pbaron2/station-sol-supsat/antenne/synthese-projet.docx

substrat FR4 : er=4.3, h=1.586 mm

cuivre : 18µm d'épaisseur

coupleur 3dB/90°

w=3L=95.5, w=3L=98, w=3

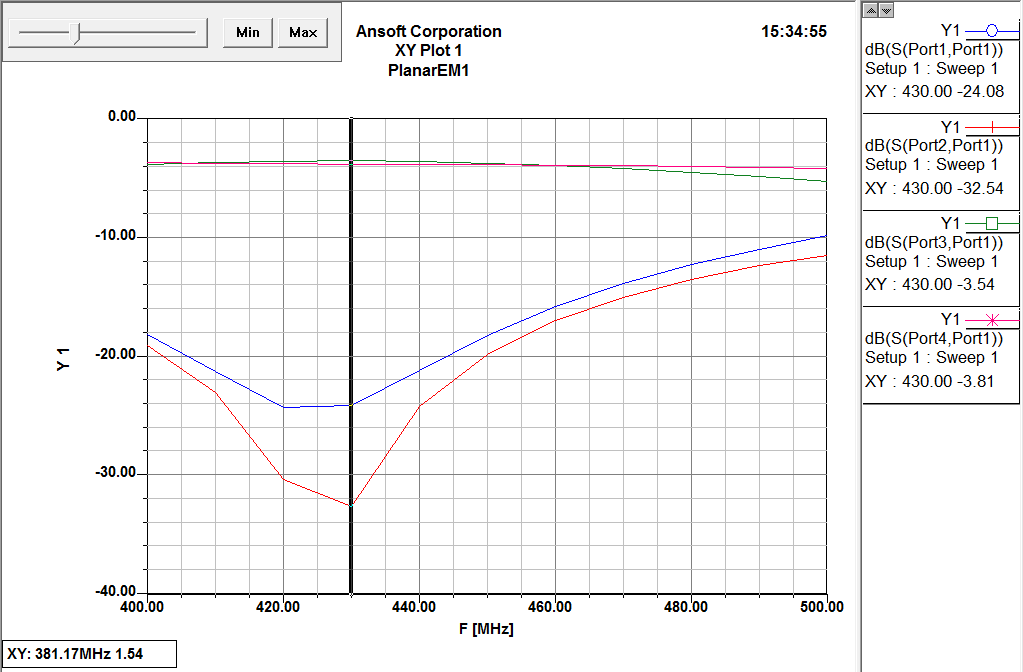
[picture p1: figure]
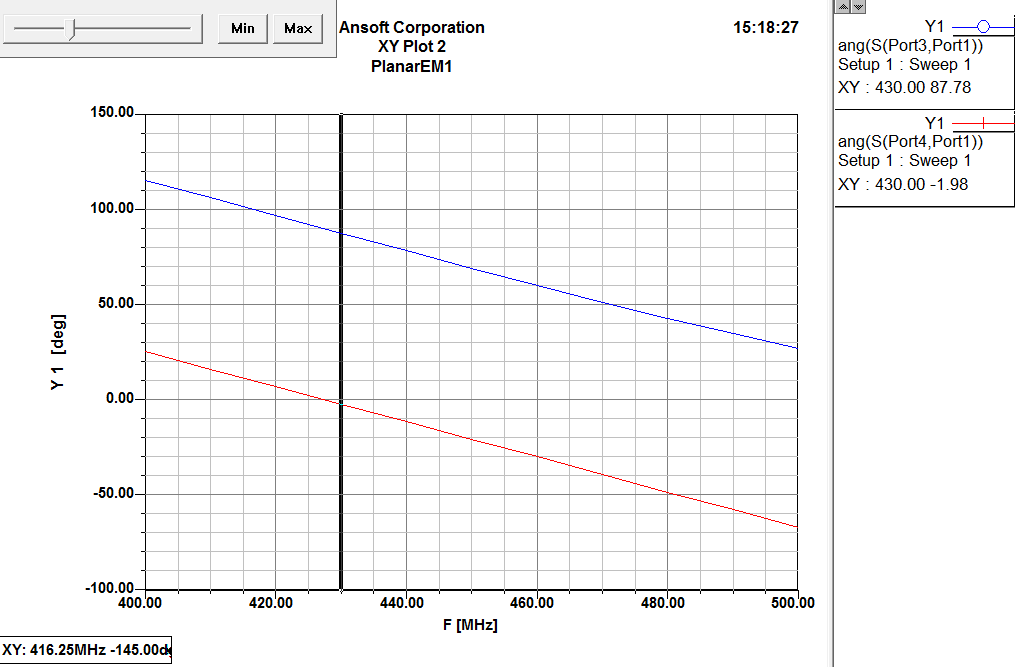
[picture p2: figure]

coupleur 3dB/180°

L=96, w=1.6L=96, w=1.6L=33.2L=29.6L=10L=15L=29.6L=33L=33

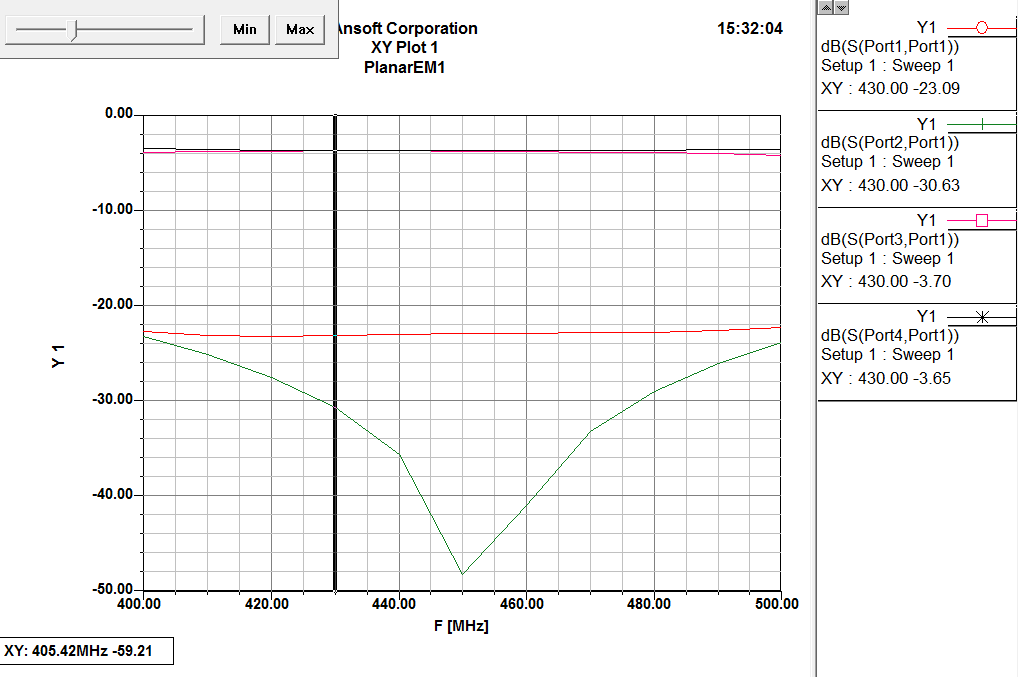
[picture p3: figure]
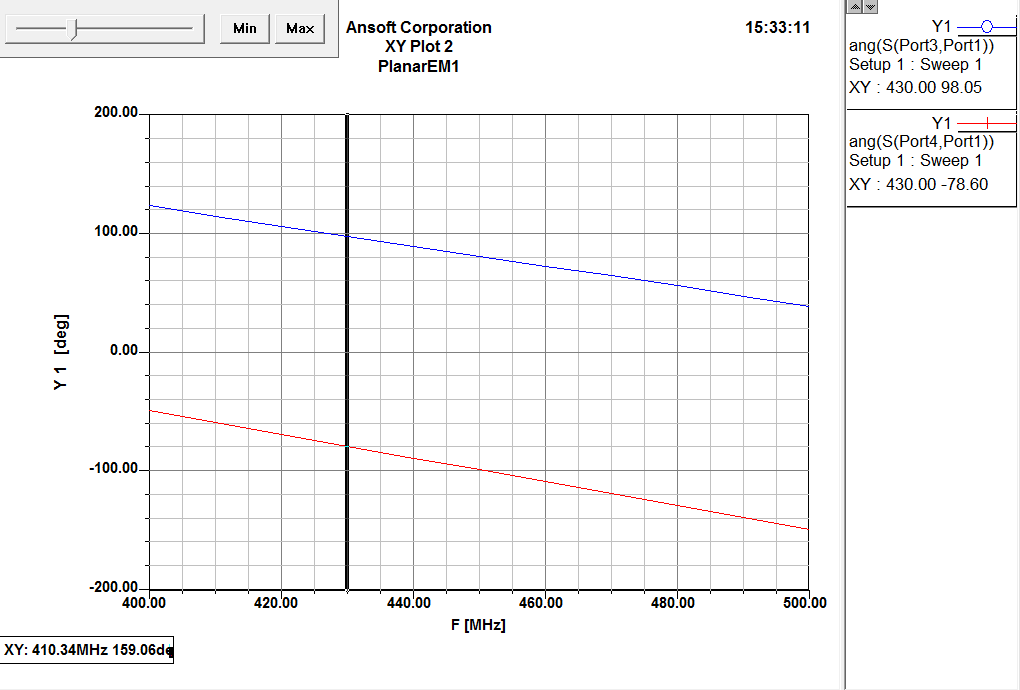
[picture p4: figure]

Alimentation en rotation séquentielle

des 4 patchs

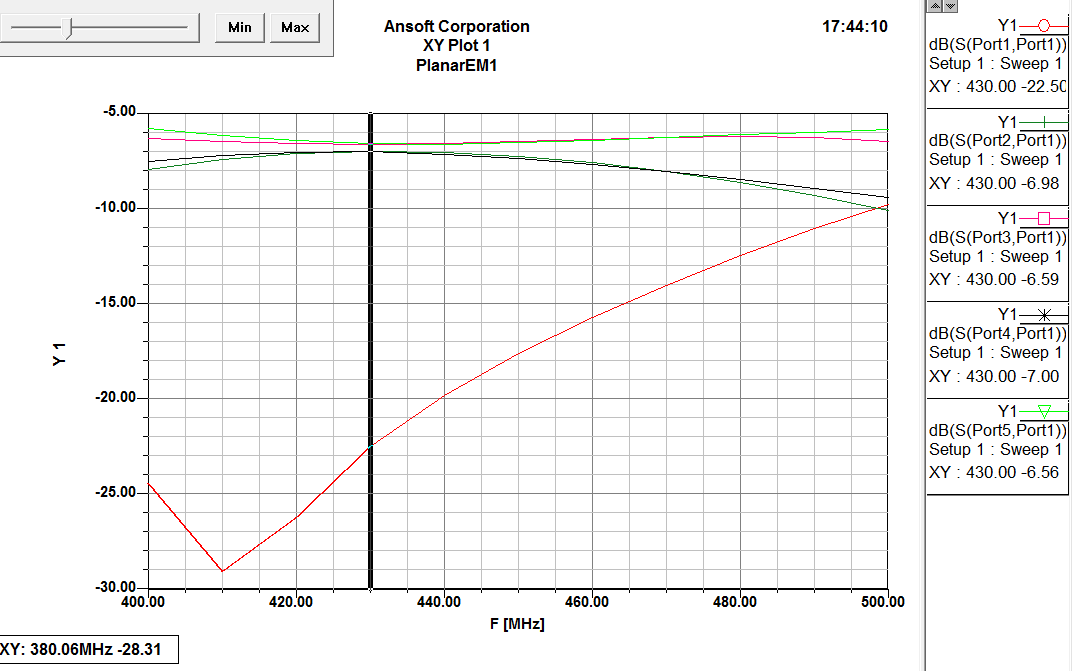
[picture p5: figure]
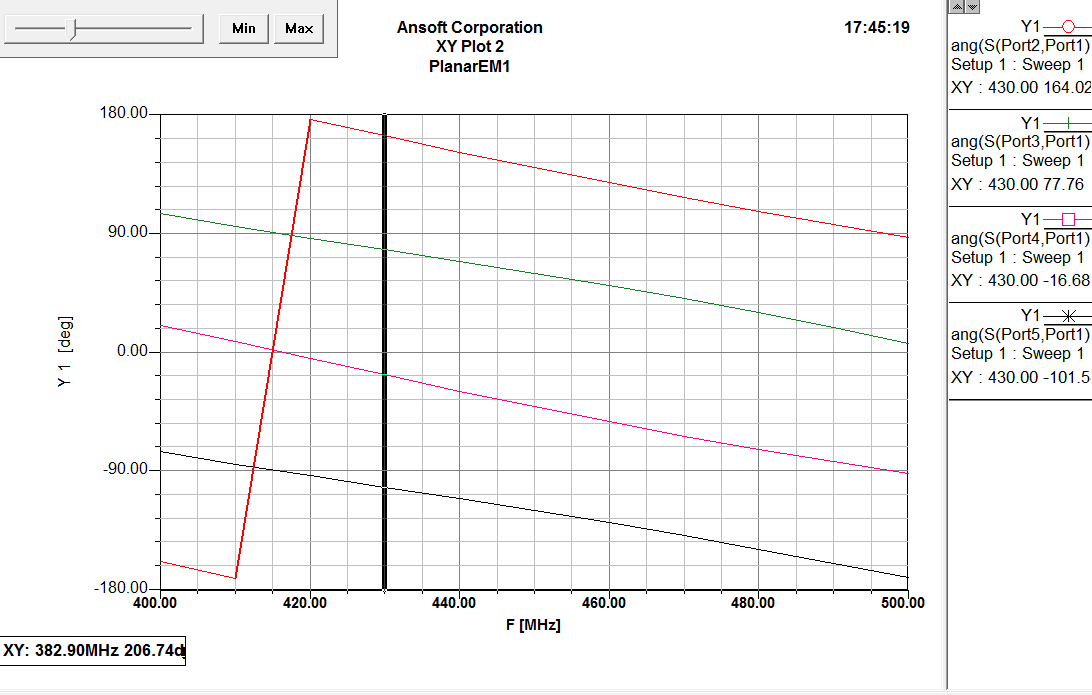
[picture p6: figure]

patch alimenté par connecteur coaxial 50 Ω

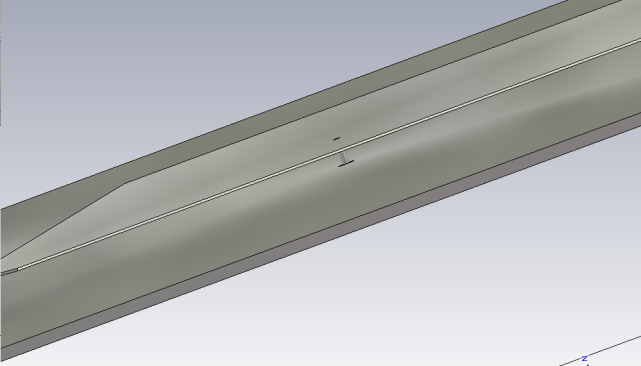
[picture p7: figure]
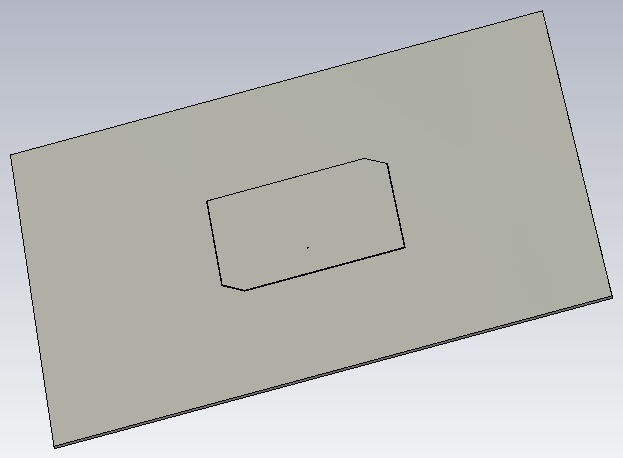
[picture p8: figure]
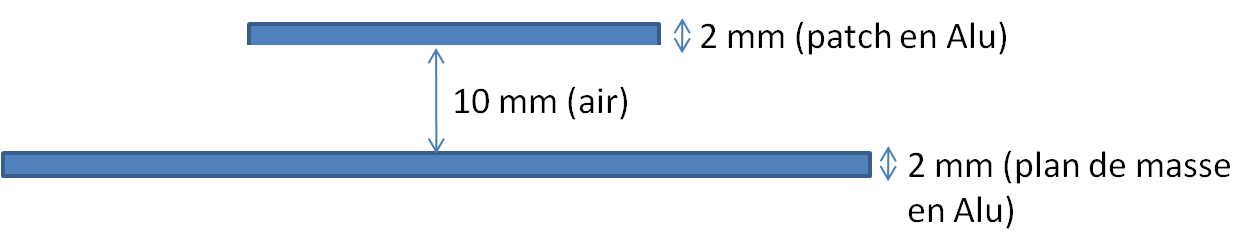
[picture p9: figure]
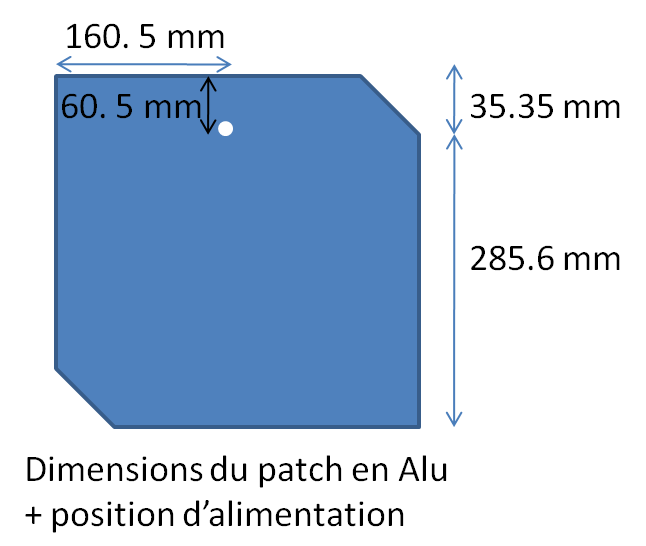
[picture p10: figure]
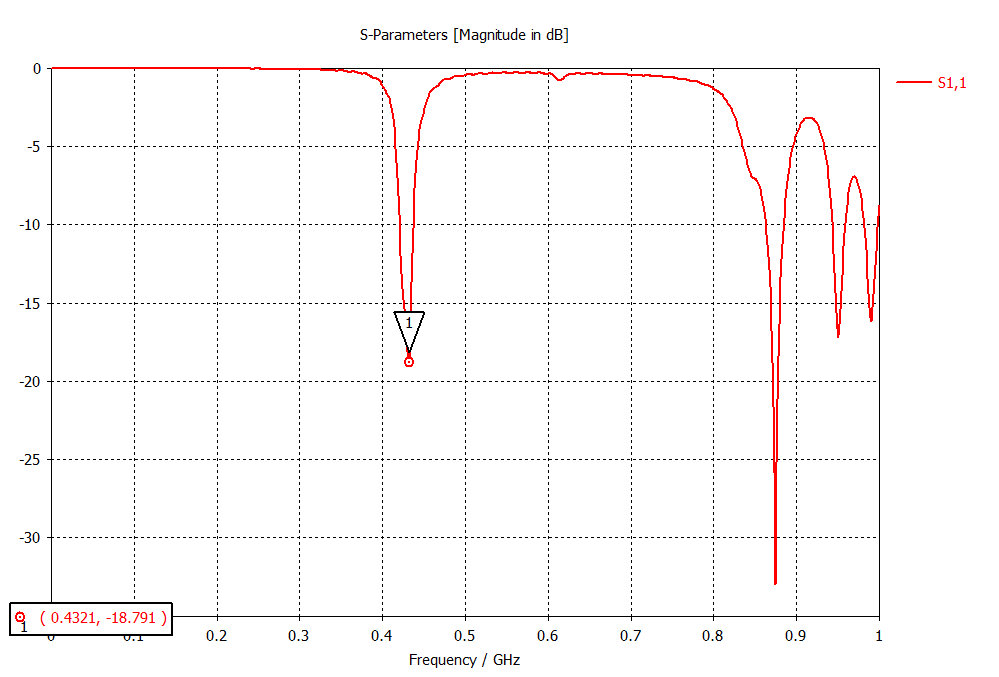
[picture p11: figure]
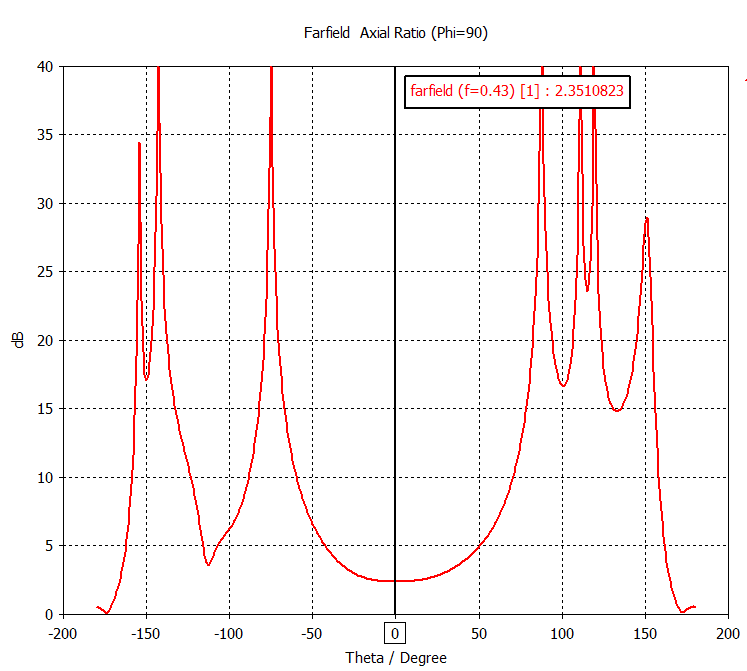
[picture p12: figure]

l'adaptation d'entrée rapport d'ellipticité

réseau de 4 patchs alimentés par un circuit en rotation séquentielle

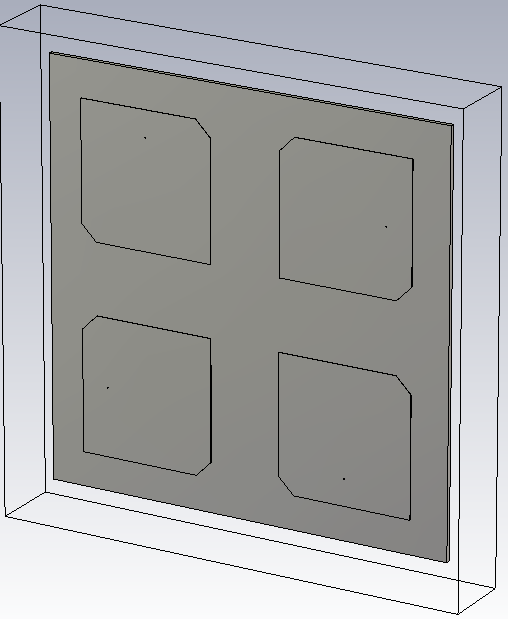
[picture p13: figure]
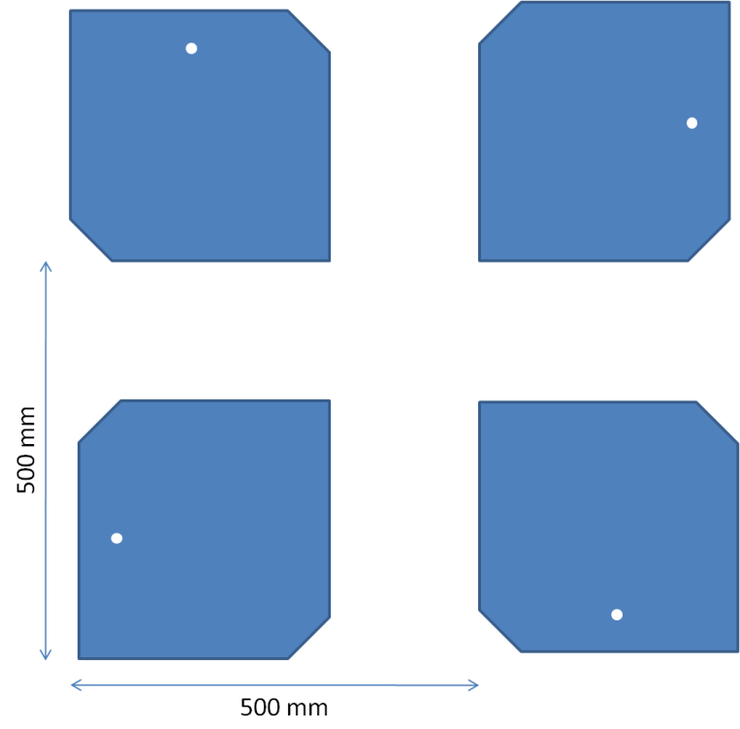
[picture p14: figure]
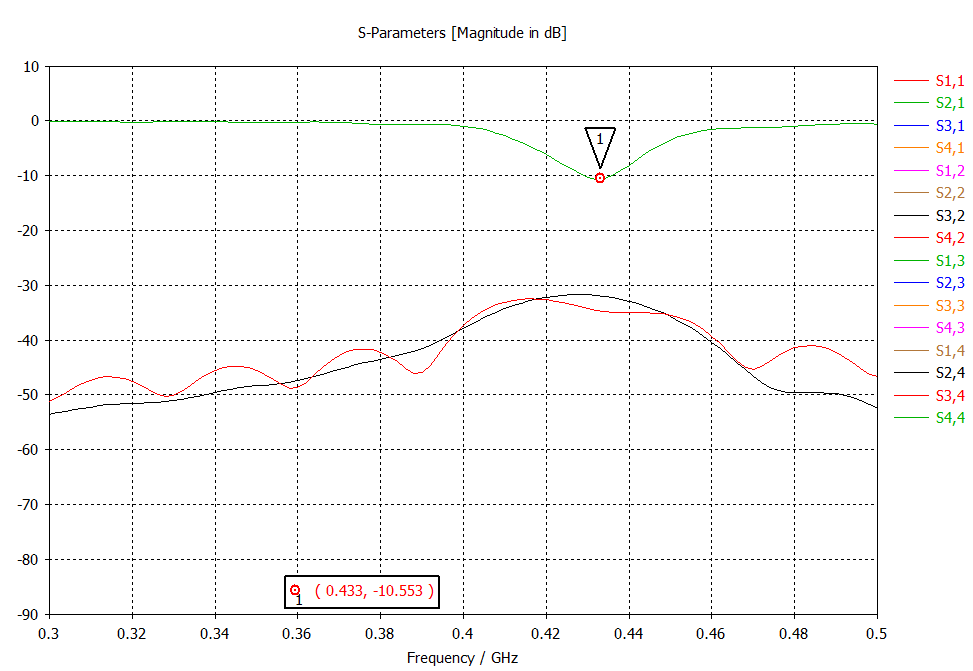
[picture p15: figure]
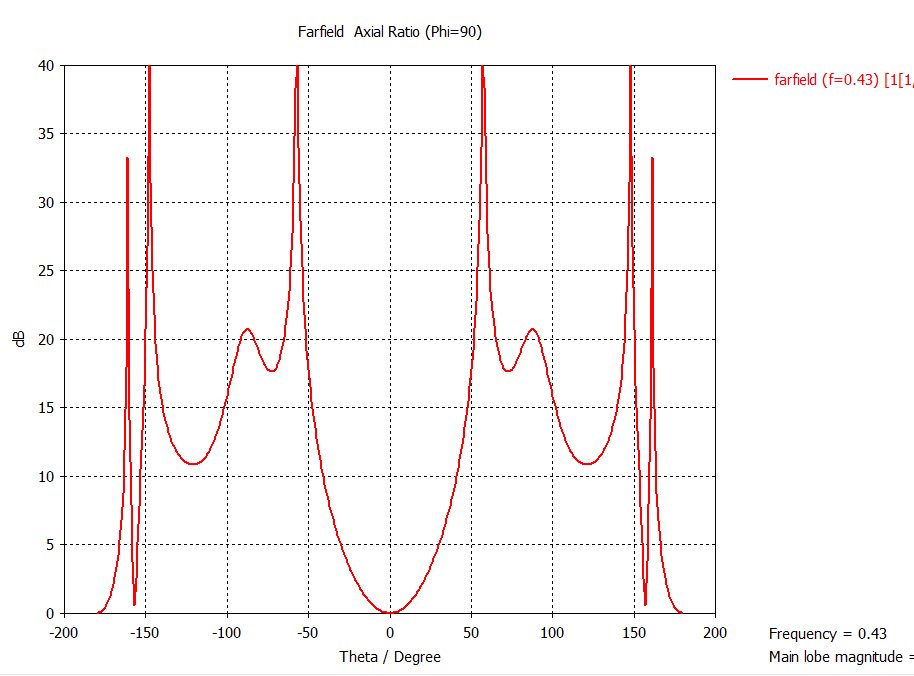
[picture p16: figure]

l'adaptation d'entrée rapport d'ellipticité

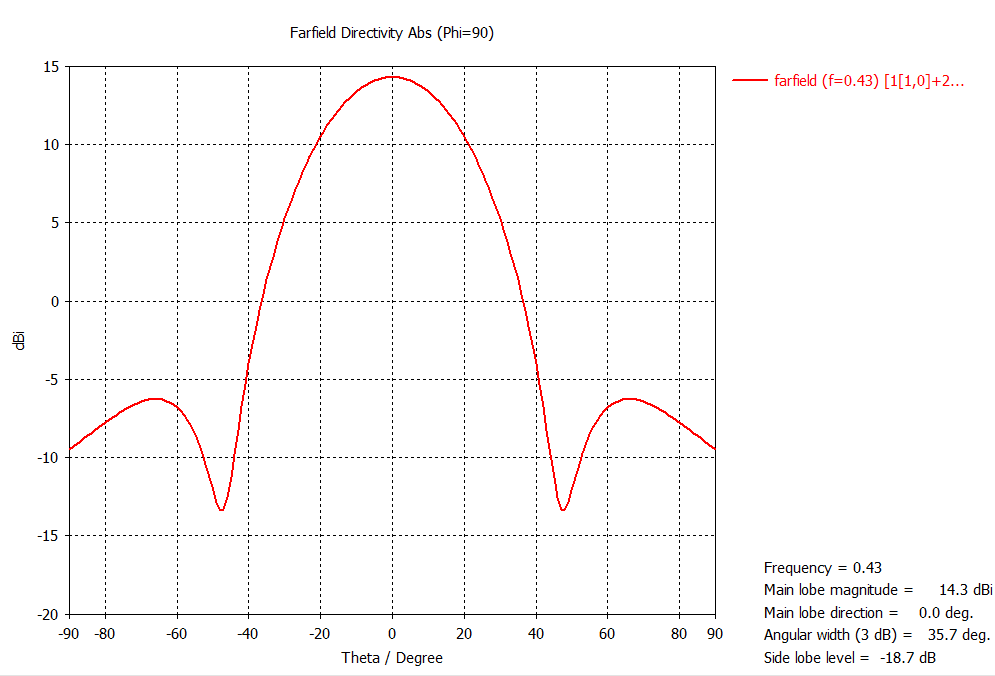
[picture p17: figure]

Antenne Hélice

à 430 MHz λo=697,7 mm

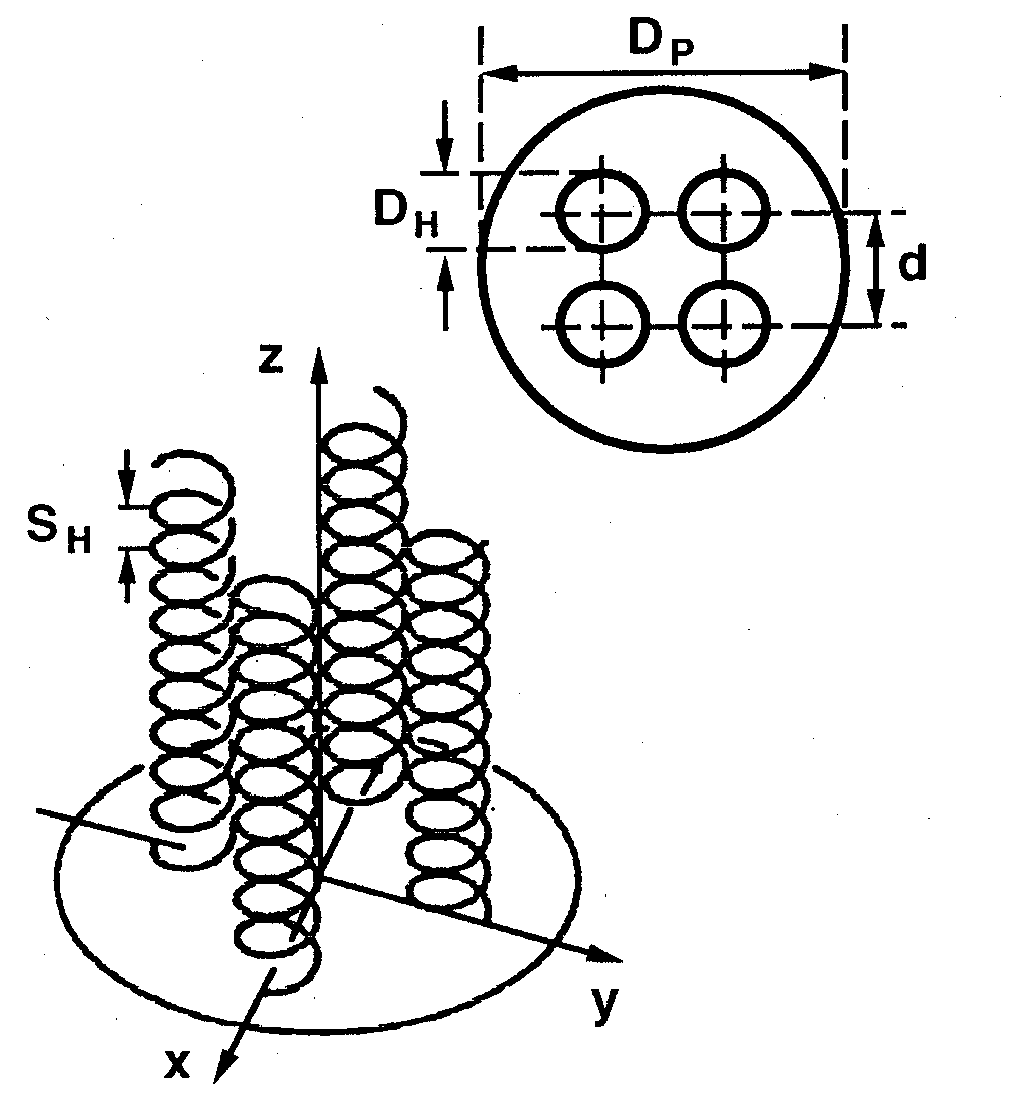
[picture p18: figure]

Diamètre : DH=C/π

0.75 λo <C<1.33 λo

C=0.974 λo= 679,5mm

DH= 216,3 mm

Hauteur du pas : SH= λo /4.8

SH= 145 mm

α=tan−1(S/πD)= tan−1(145/π216.3)=12°

Nombre de tours : N=10

hauteur de l'antenne = 1.45 m

Réseau d'antennes Hélice

Distance inter-éléments : d= 0.72 λo

d= 502 mm

un Hélice de 1.5 m de hauteur : un gain = 11.7 dBi à 430 MHz

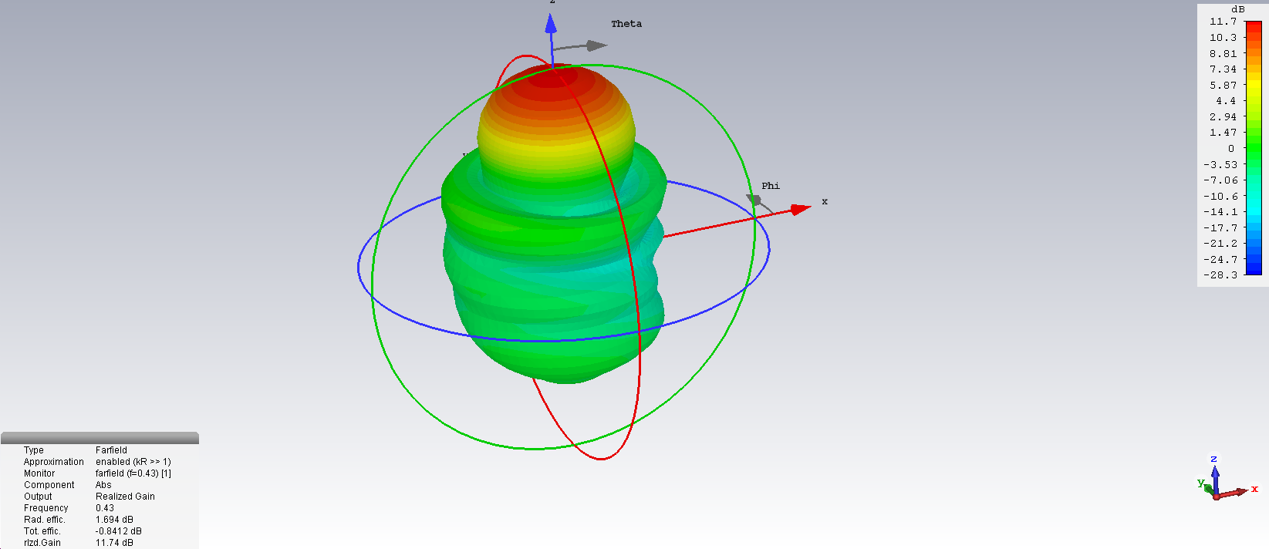
[picture p19: figure]

Réseaux de 4 Hélices sur un carré de 50x50 cm : Gain 15.4 dB

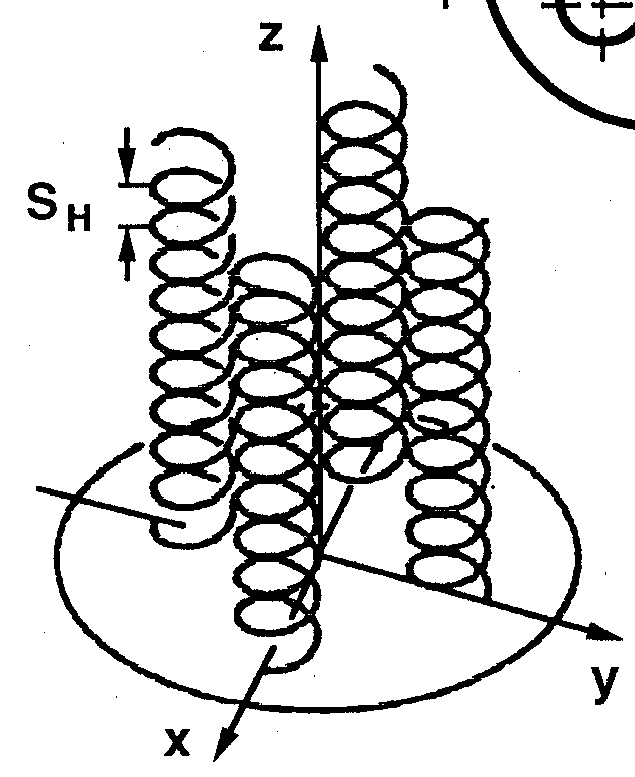
[picture p20: figure]
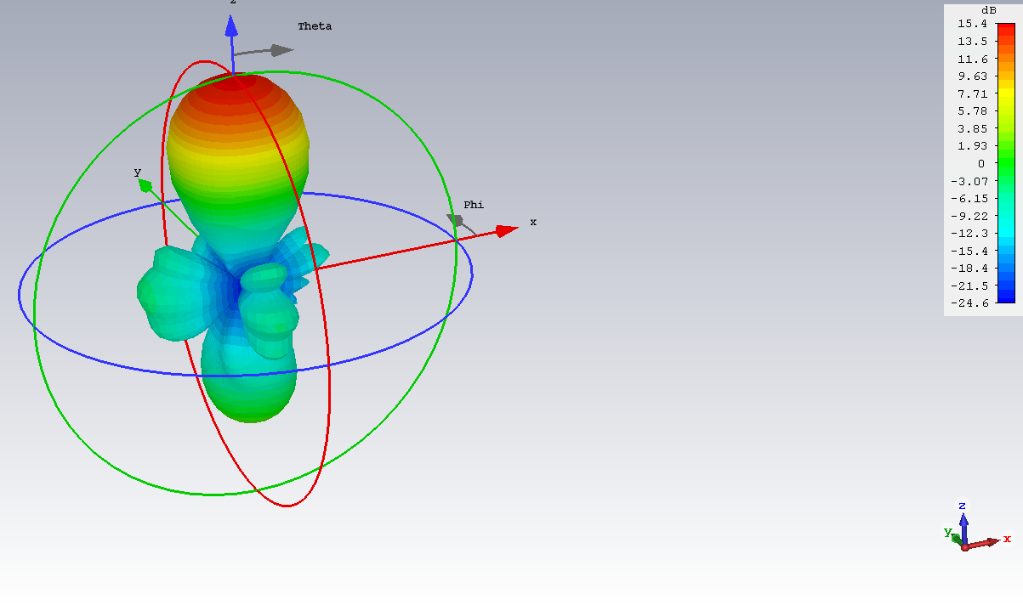
[picture p21: figure]
