pbaron2/station-sol-supsat/rapports/poster/poster_v4.pdf

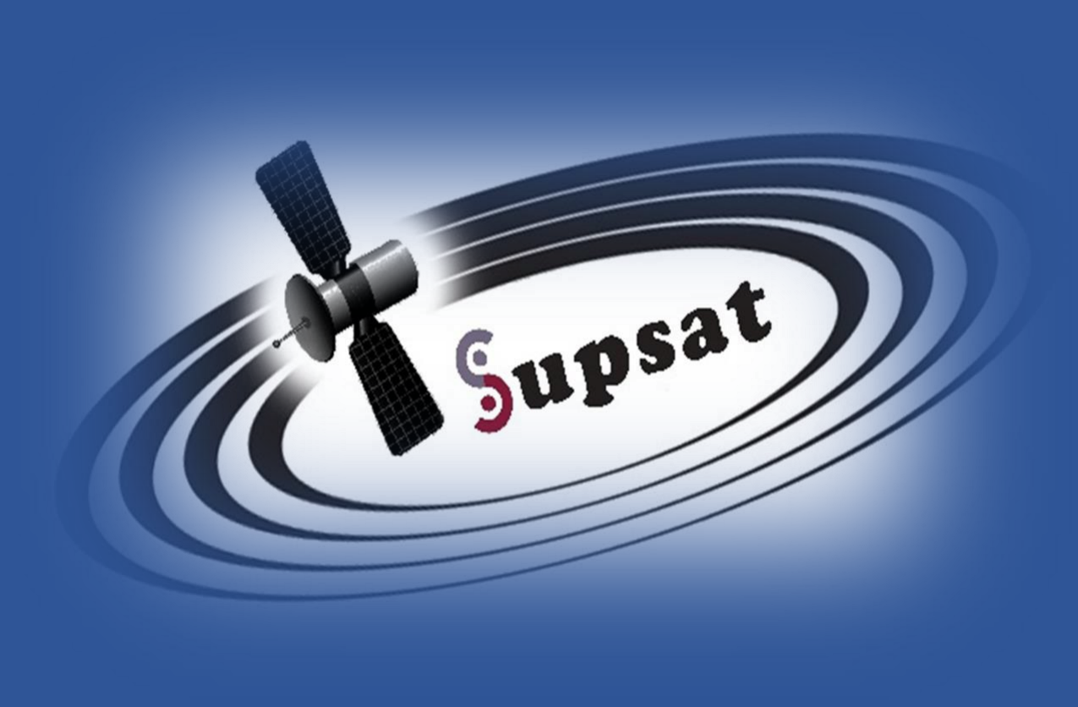
[picture p30: figure]

# Supsat

### Paul BARON – Alexandre DELFOSSE – Adel M’FOUKH

Encadrants : Amor NAFKHA – Jacques WEISS

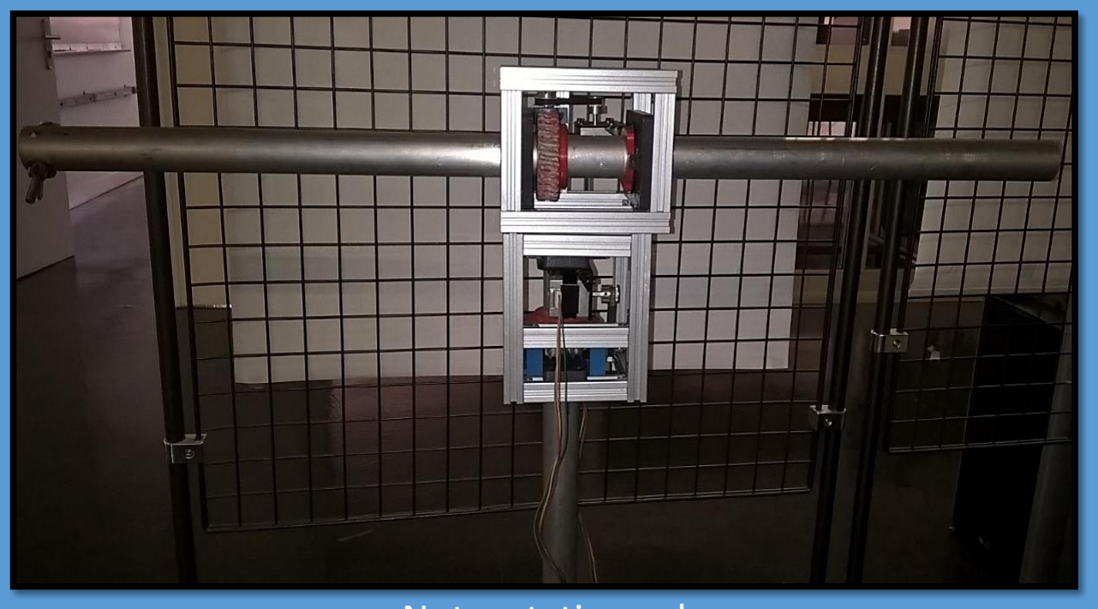
[picture p31: figure]

# Structure et mécanique

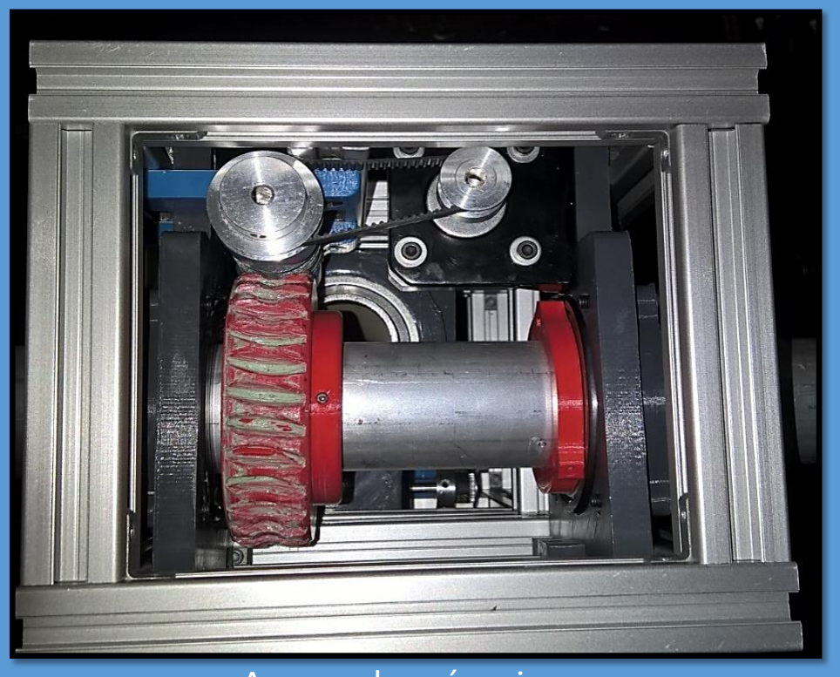
[picture p32: figure]

Aperçu du mécanisme

Angles d’azimut et d’élévation

Chaine de transmission

Boitier entier

Boitier inférieur en vue éclatée

Afin de suivre un satellite donné, notre système doit s’orienter en direction dudit satellite afin de maximiser la qualité du signal reçu.

Cette structure est en partie imprimée en 3D et s’inspire d’un projet libre SatNogs.

# Contexte

Ce projet long s’inscrit dans le cadre de l’association Supsat fondée en 2012 dans l’objectif de lancer un cubesat pour mesurer le rayonnement solaire en orbite basse afin d’étudier l’utilisation d’un FPGA commercial associé à la reconfiguration dynamique partielle en remplacement de technologies de durcissement coûteuses pour résister aux agressions des particules solaires.
La conception et la construction de la station sol doit permettre la communication avec des nanosatellites. Initié il y a deux ans, ce projet a pour objectif final de recevoir les données du futur cubesat de Supsat et de lui envoyer les commandes de fonctionnement.

Swisscube de l’EPFL

Nous contrôlons alors l’axe d’azimut et l’axe d’élévation avec des moteurs pasà-pas par l’intermédiaire d’un système de réduction irréversible pour positionner précisément l’antenne.

Un boitier imprimé en 3D protège le mécanisme et l’électronique à l’intérieur de la station.
Ce boitier permet de fixer les circuits, les câbles et la batterie
Des portes permettent d’accéder aux composants principaux.

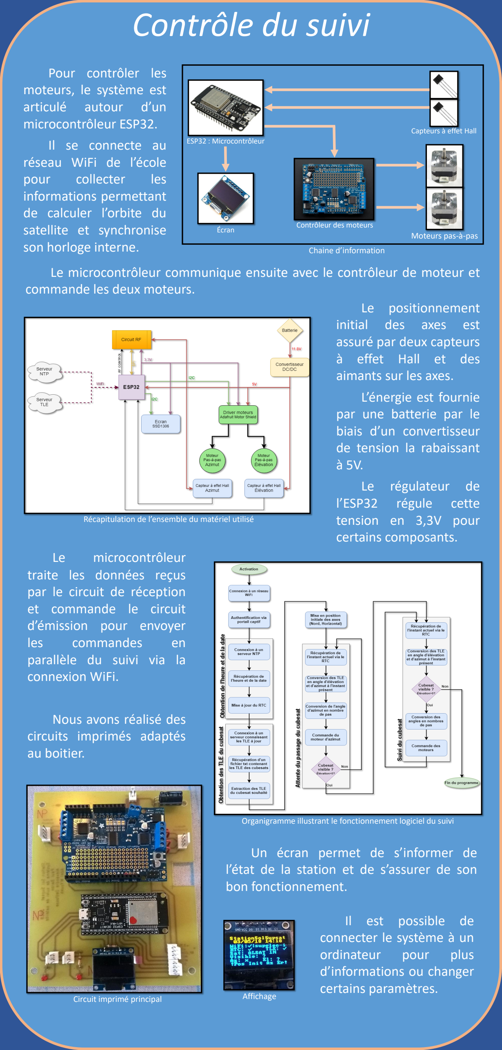
[picture p33: figure]
Chaine d’information; ESP32 : Microcontrôleur; Contrôleur des moteurs; Écran; Capteurs à effet Hall; Moteurs pas-à-pas; Contrôle du suivi; Pour contrôler les moteurs, le système est; articulé; autour; microcontrôleur ESP32.; Il se connecte au réseau WiFi de l’école; pour; collecter; les; informations permettant de calculer l’orbite du satellite et synchronise son horloge interne.; commande les deux moteurs.; Le positionnement initial des axes est assuré par deux capteurs à effet Hall et des aimants sur les axes.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

Le microcontrôleur communique ensuite avec le contrôleur de moteur et

Récapitulation de l’ensemble du matériel utilisé

l’état de la station et de s’assurer de son

Organigramme illustrant le fonctionnement logiciel du suivi

# Réception et émission

Notre station sol

La réception et l’émission des signaux sont assurés par l’antenne et le circuit radiofréquence. Ces éléments ont été conçus avec l’aide de l’IETR.

L’antenne se compose d’un réseau de patchs adaptés à la fréquence de communication de 433,5MHz pour la réception et l’émission.
Cette structure assure un gain suffisant pour la communication avec notre cubesat.

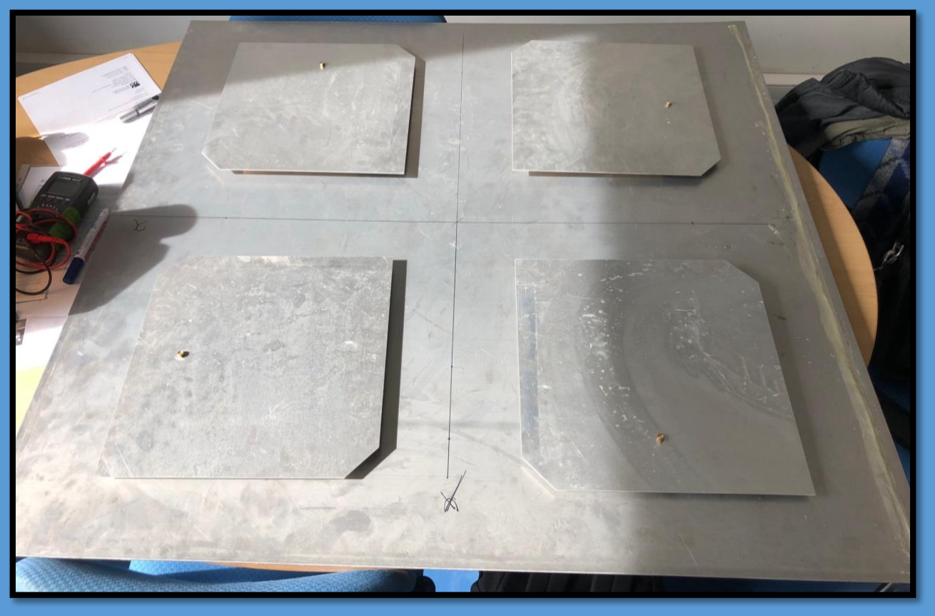
[picture p34: figure]

Le circuit RF doit permettre l’amplification et le filtrage du signal reçu pour préparer son traitement. Il doit également amplifier le signal à émettre pour atteindre l’orbite basse. Un switch assure la commutation entre ces deux fonctions.

Prototype du réseau d’antennes patchs

Diagramme de gain simulé de l’antenne

Conception du PCB du circuit radiofréquence

Le microcontrôleur du système de suivi contrôlera finalement le transceiver pour la communication ainsi que l’activation des différents composants du circuit RF.

## Projet long 2017/2018
