pbaron2/station-sol-supsat/rapports/sujet.odt

| PROJET LONG | N° ref projet Jacques WEISS Amor NAFKHA
Campus de Rennes 2017-2018 | | Electronique Informatique

Projet SupsaT

amélioration DE LA STAtion sol

# Contexte du projet et application

Ce projet s’inscrit dans le cadre du projet de nano-satellite mené à Supélec sous la direction de l’association SUPSAT qui a pour but de réaliser un nano-satellite de type Cubesat pour expérimenter et valider des technologies développées à Supélec, dans l’espace, tout en remplissant trois objectifs :

- Educatif : La construction d’un système complexe comme un nano-satellite est motivante pour les étudiants. Ceux-ci réalisent ainsi, avec le soutien de membres de la recherche et de l’industrie la plupart des tâches de A à Z. Les étudiants ont par ce biais l’opportunité d’appliquer leurs connaissances et leur savoir-faire dans un domaine de haute technologie : l’aérospatial.

- Scientifique : Le nano-satellite doit emporter avec lui un laboratoire permettant de faire des expériences en orbite sur la reconfiguration dynamique partielle des FPGAs avec en particulier trois thématiques : la tolérance aux fautes de type durcissement logiciel, les mises à jour sans interruption de service, l’optimisation de la consommation énergétique

- Technologique : Si les principes des expériences effectuées sont vérifiés, des applications de ceux-ci sur des systèmes autres que de recherche pourront être envisagées, avec tous les avantages que ces nouvelles solutions technologiques impliquent.

Objectifs & Cahier des charges

Ce projet concerne la station sol du projet Supsat. Cette station permet d’acquérir les signaux venant de satellites et de les enregistrer pour un traitement sur ordinateur.

Le groupe qui choisira ce projet s’inscrira dans la continuité du projet de l’an passé « Station Sol » mené par Fabien BALCON, Guillaume PATTIER et Thomas LE GOFF (bureau Supsat 2016-2017). Le projet a bien été mené mais il reste des améliorations à apporter.

L’équipe Supsat s’attend à ce que l’équipe qui souhaite reprendre ce projet reprenne bien en main l’ensemble de ce qui a déjà été fait et poursuive le travail notamment par exemple sur les points suivants, évoqués à la fin du rapport :

- Ajouter une option de synchronisation de la RTC par internet automatique
- Revoir le script de gestion des moteurs de la station (gestion des angles…)
- Dimensionner correctement et effectivement la batterie
- Vérifier que la réception avec l’antenne Yagi fonctionne correctement
- Evaluer la puissance du signal reçu en réception et essayer d’asservir la position de l’antenne afin de maximiser le gain en réception
- Revoir la mécanique de la station sol

C’est un projet complet qui touche à beaucoup de domaine.

Dans un souci d’amélioration de la gestion du projet Supsat, l’association souhaiterait que le groupe fournisse un compte rendu clair ainsi que les pistes d’améliorations en fin de projet.

Domaines concernés

- Electronique numérique
- Electronique haute fréquence (réception, antennes)
- Mécanique
- Informatique
- Gestion de projet
