pbaron2/station-sol-supsat/bilan_de_liaison/Notes bilan de liaison.docx

Le bilan effectué ne prend pas en compte les pertes dues a l’atmosphère et la ionosphère, c’est pertes étant négligeables (<<1dB) dans la zone utile de tracking (élévation >10°).

Il faut également avoir en tête que le bilan est établi dans l’hypothèse ou le satellite passe parfaitement au dessus de la station… Ce qui ne sera généralement pas le cas, d’ou l’intérêt d’avoir une marge de liaison la plus importante possible.

https://e2e.ti.com/support/wireless_connectivity/proprietary_sub_1_ghz_simpliciti/f/156/t/578592
