pbaron2/station-sol-supsat/PCBs/principal/v1.1/tracking_system-brd.png

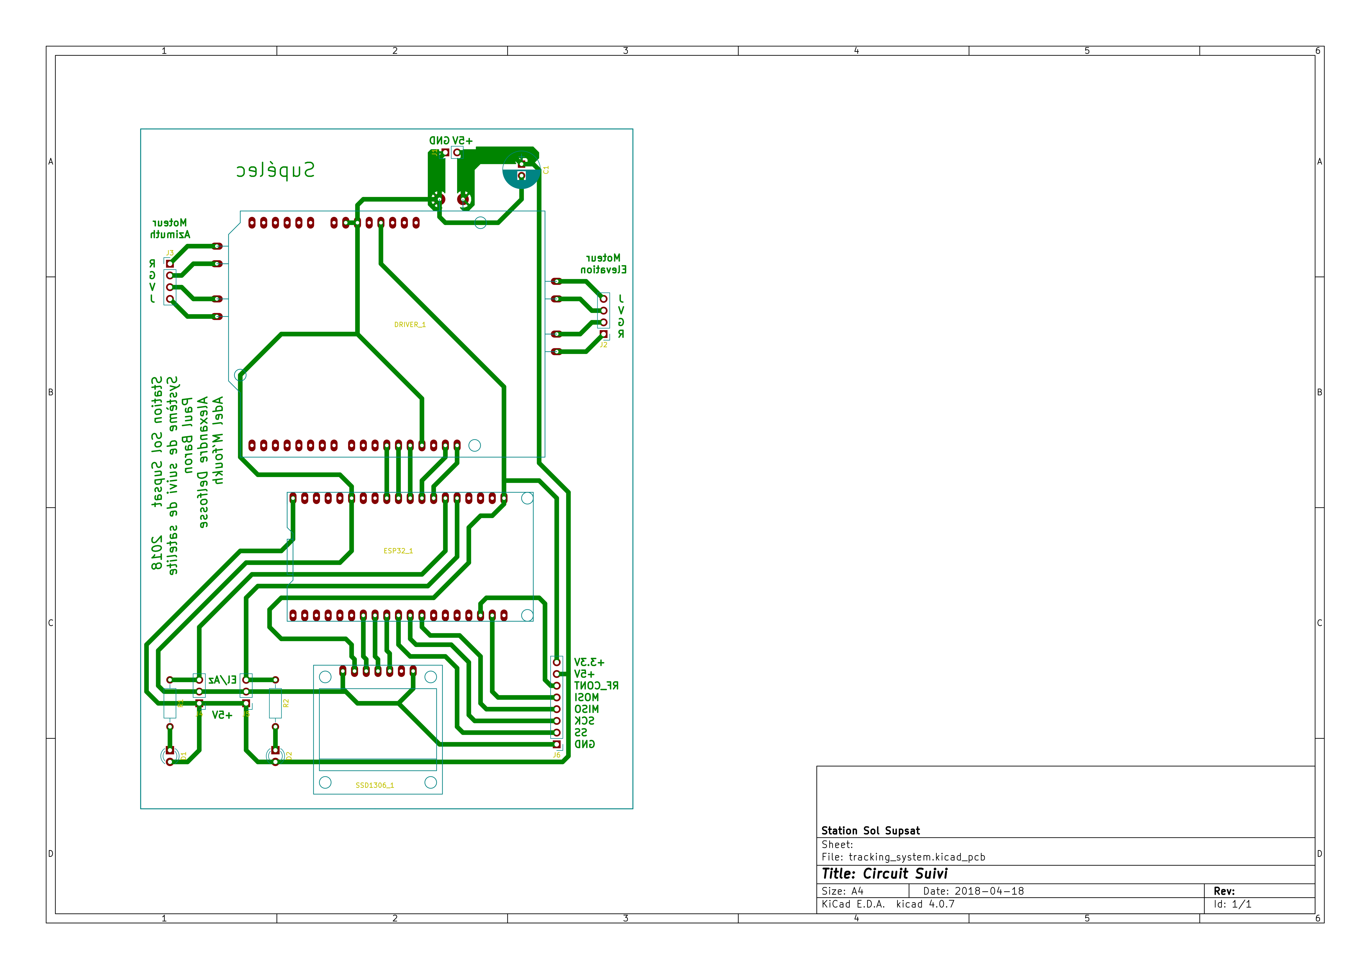
PCBs/principal/v1.1/tracking_system-brd.png
