pbaron2/station-sol-supsat/PCBs/rf/circuits_datasheet/switch.PNG

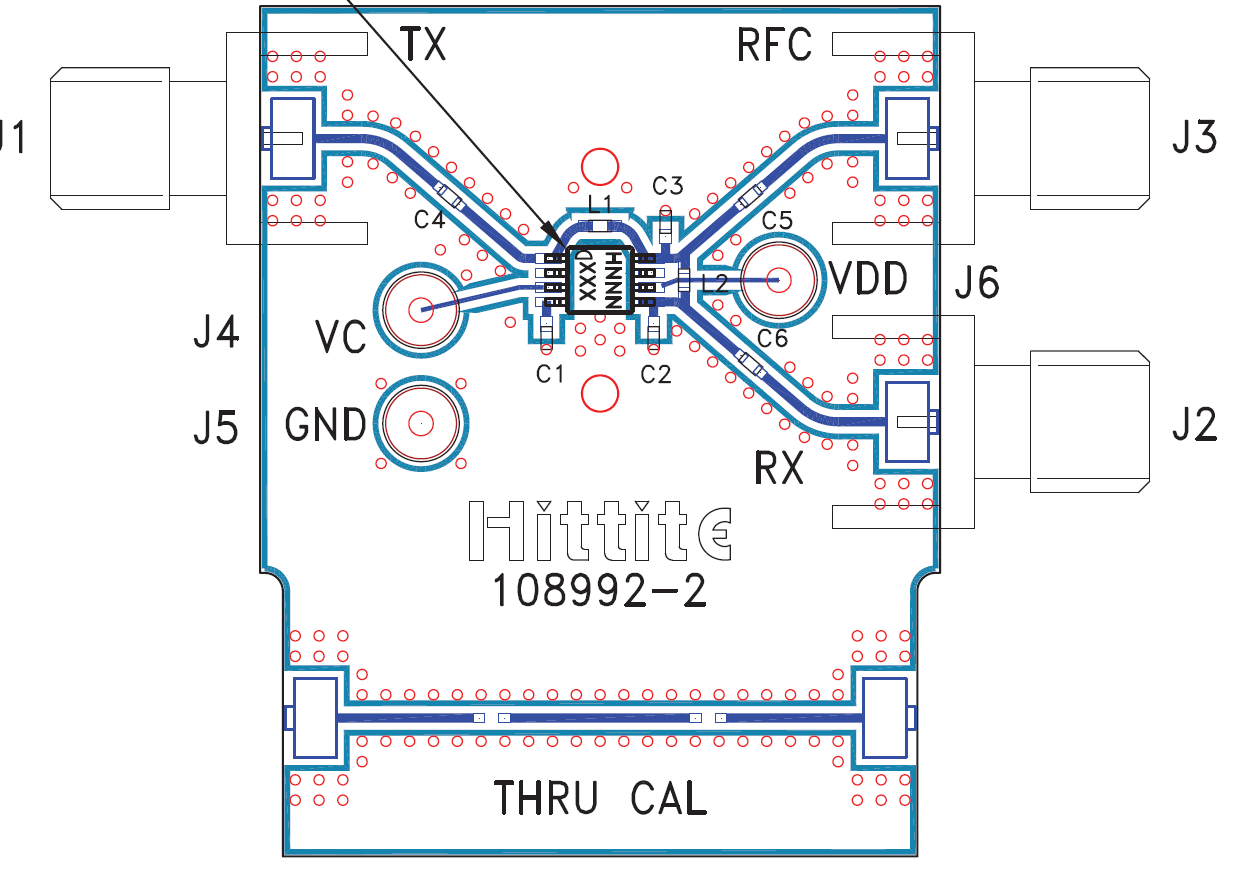
PCBs/rf/circuits_datasheet/switch.PNG
