pbaron2/station-sol-supsat/modeles_boitier/bas/hall_sensor v1.stl

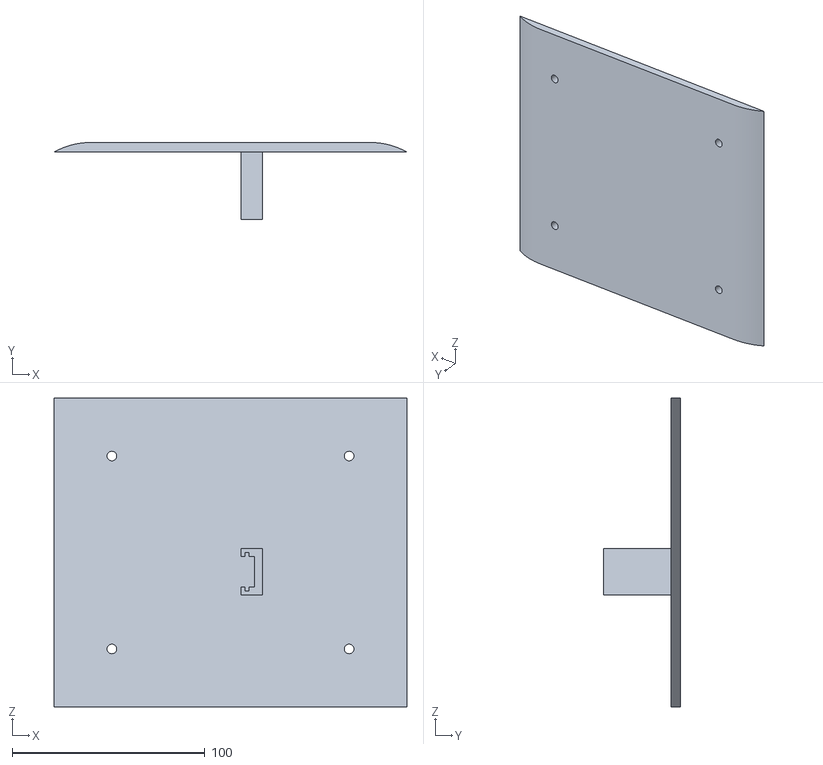
[picture p138: CAD file, 2019-05-30]
modeles_boitier/bas/hall_sensor v1.stl
183.0 x 40.0 x 160.0
