pbaron2/station-sol-supsat/modeles_boitier/haut/axe_gauche_petit v3.stl

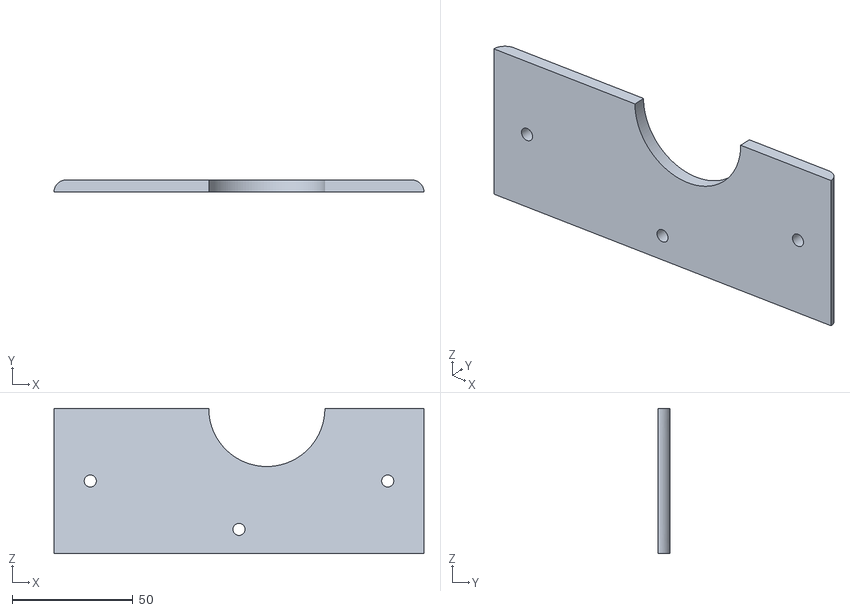
[picture p139: CAD file, 2019-05-30]
modeles_boitier/haut/axe_gauche_petit v3.stl
153.0 x 5.00 x 60.0
