pbaron2/station-sol-supsat/PCBs/rf/rf_footprints-F.Cu.dxf

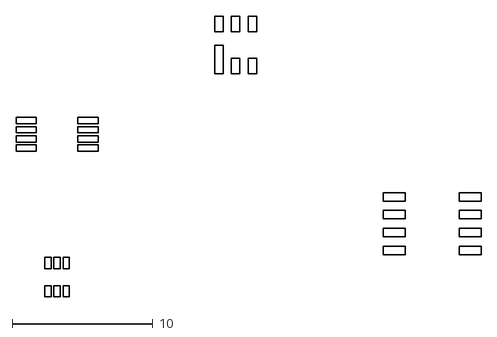
[picture p140: CAD file, 2019-05-30]
PCBs/rf/rf_footprints-F.Cu.dxf
33.1 x 20.0
