pbaron2/station-sol-supsat/structure/teneur de_vis.SLDPRT

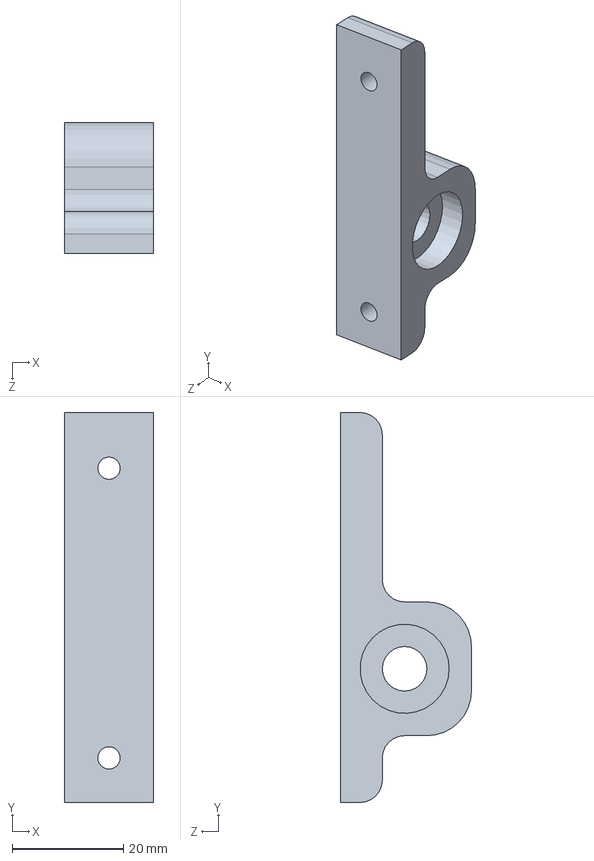
[picture p141: CAD file, 2019-05-30]
structure/teneur de_vis.SLDPRT
16.0 x 70.0 x 23.5 mm
