pbaron2/station-sol-supsat/modeles_boitier/bas/motor_bas v1.stl

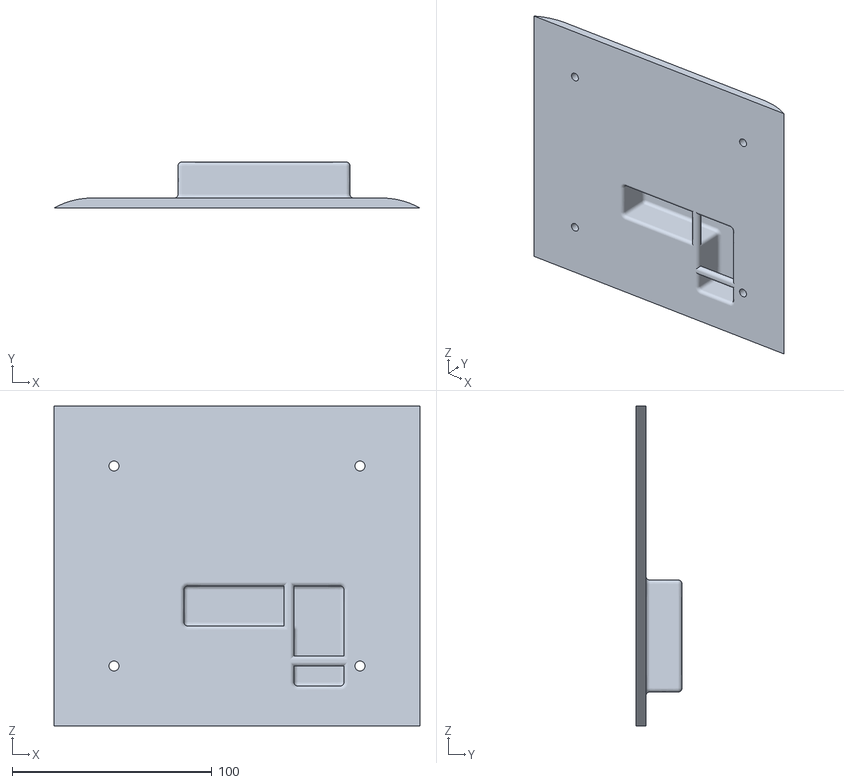
[picture p142: CAD file, 2019-05-30]
modeles_boitier/bas/motor_bas v1.stl
183.0 x 23.0 x 160.0
