pbaron2/station-sol-supsat/modeles_boitier/bas/ci_principal_v6.stl

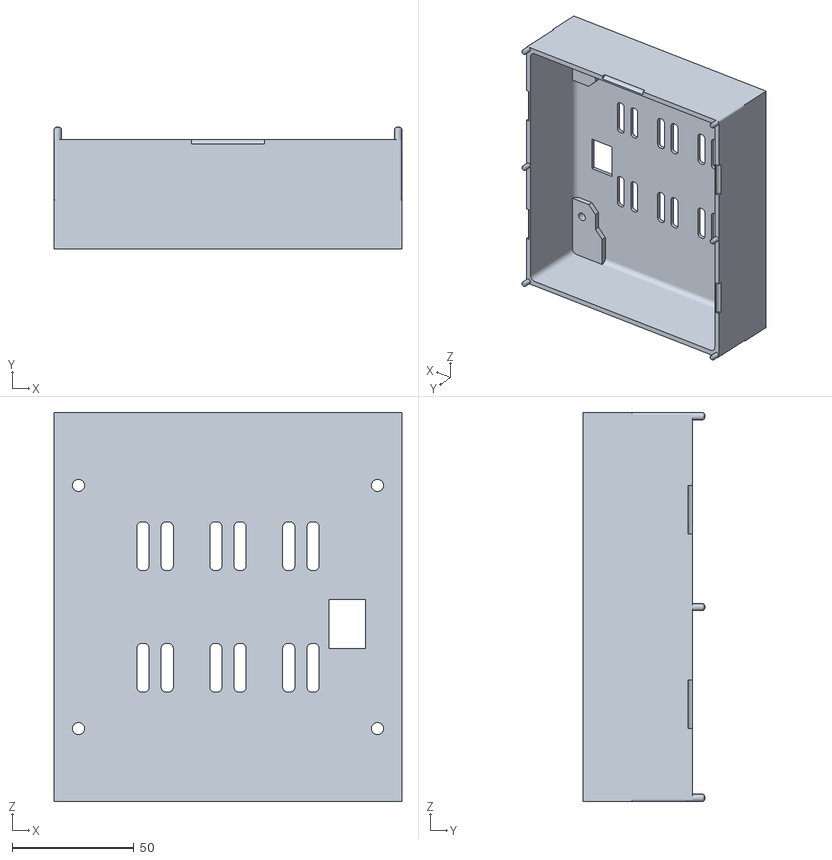
[picture p143: CAD file, 2019-05-30]
modeles_boitier/bas/ci_principal_v6.stl
143.0 x 50.0 x 160.0
