pbaron2/station-sol-supsat/modeles_boitier/bas/alim_base v2.stl

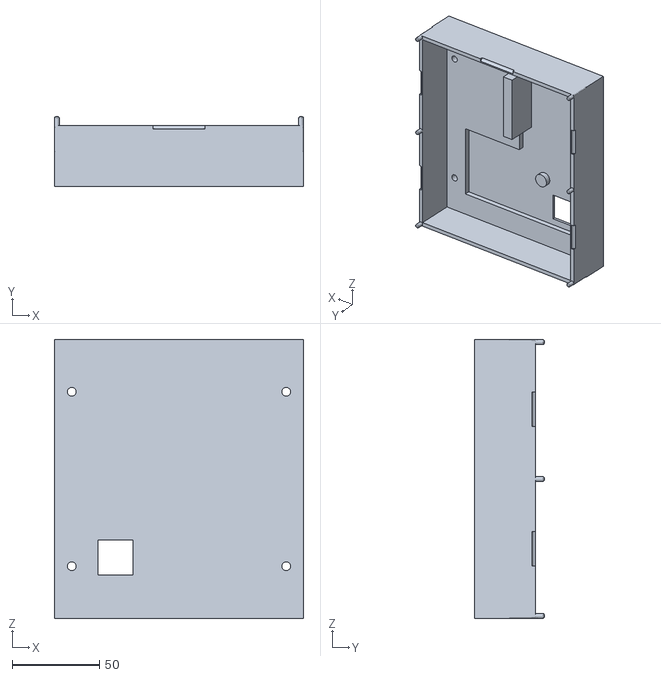
[picture p145: CAD file, 2019-05-30]
modeles_boitier/bas/alim_base v2.stl
143.0 x 40.0 x 160.0
