pbaron2/station-sol-supsat/modeles_boitier/haut/motor_haut v5.stl

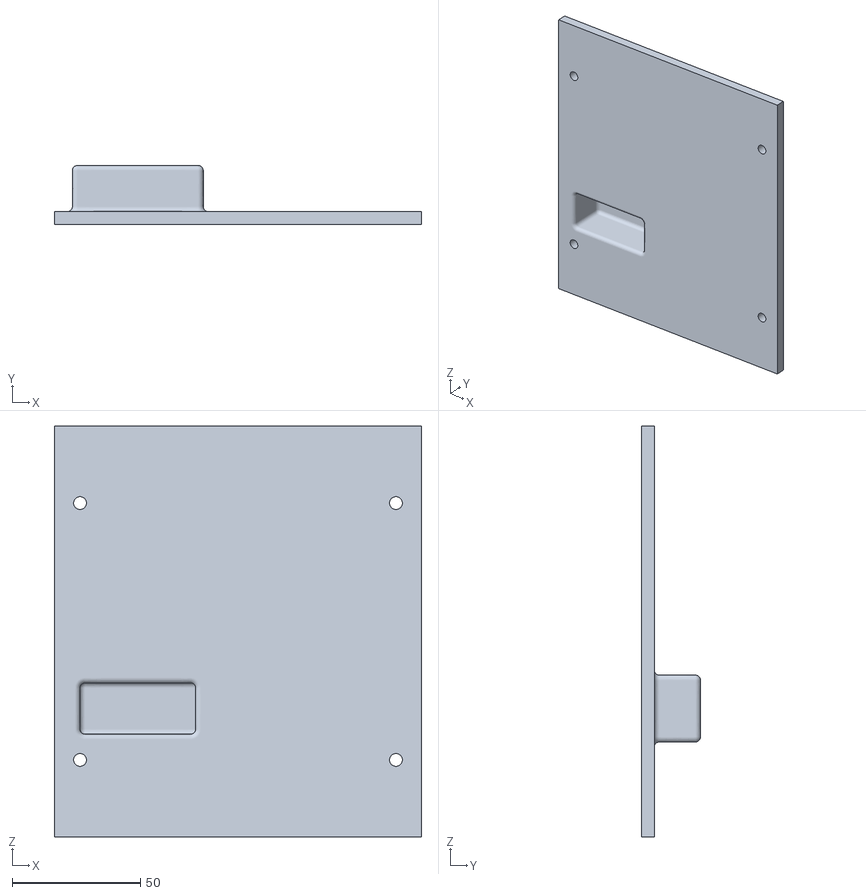
[picture p146: CAD file, 2019-05-30]
modeles_boitier/haut/motor_haut v5.stl
143.0 x 23.0 x 160.0
