pbaron2/station-sol-supsat/modeles_boitier/bas/ci_principal_capot v2.stl

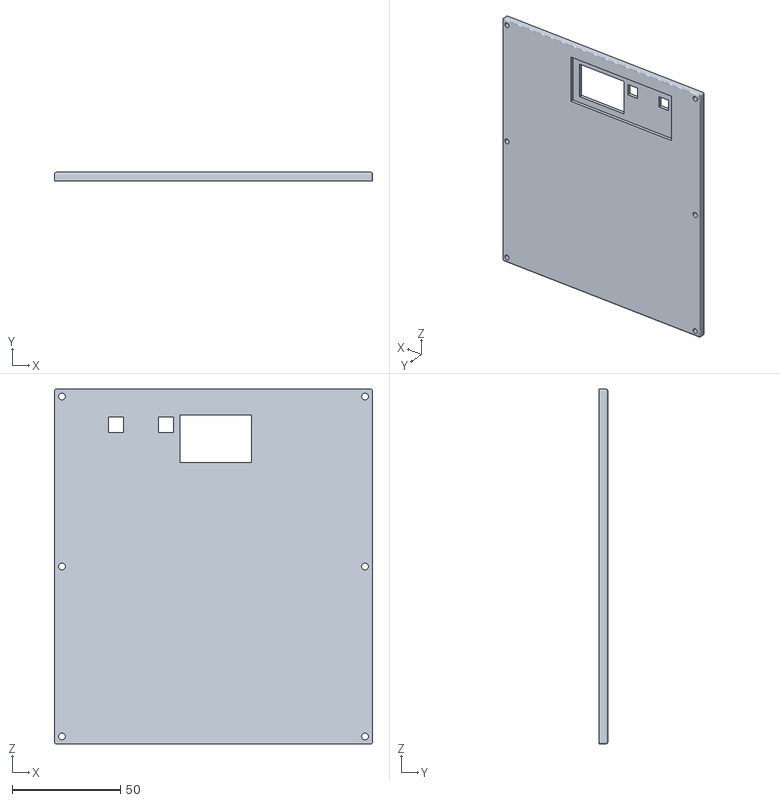
[picture p149: CAD file, 2019-05-30]
modeles_boitier/bas/ci_principal_capot v2.stl
147.0 x 4.00 x 164.0
