pbaron2/station-sol-supsat/modeles_boitier/haut/haut v4.stl

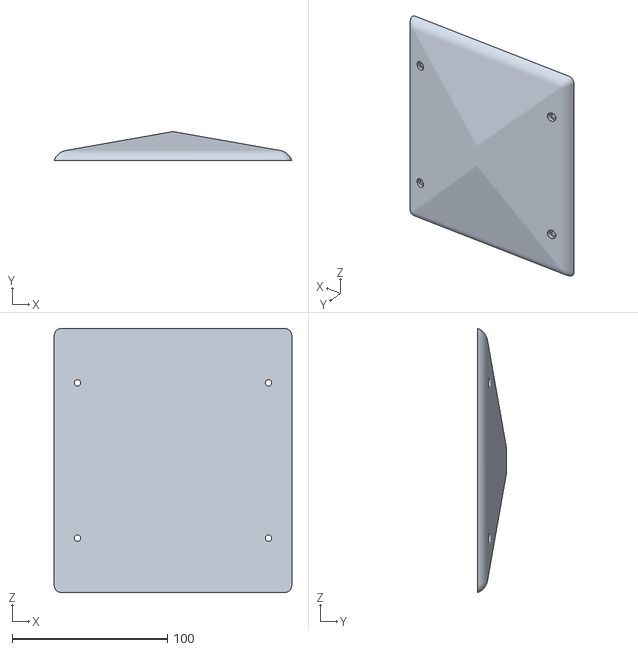
[picture p150: CAD file, 2019-05-30]
modeles_boitier/haut/haut v4.stl
153.0 x 18.4 x 170.0
