pbaron2/station-sol-supsat/modeles_boitier/bas/axe_dessous_grande v1.stl

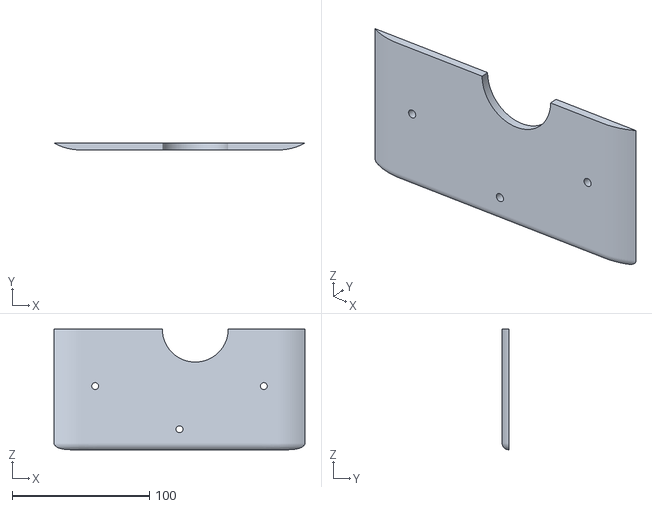
[picture p151: CAD file, 2019-05-30]
modeles_boitier/bas/axe_dessous_grande v1.stl
183.0 x 5.00 x 88.0
