pbaron2/station-sol-supsat/(list of files, cad)

Other CAD files:
modeles_boitier/haut/axe_droit_petit v5.stl
PCBs/rf/rf_footprints-B.Cu.dxf
PCBs/rf/rf_v2/rf_footprints-B.Cu.dxf
structure/teneur_de_vis_miroir.SLDPRT
modeles_boitier/haut/axe_gauche_grande v2.stl
modeles_boitier/bas/alim_capot v2.stl
PCBs/rf/rf_footprints-B.SilkS.dxf
PCBs/rf/rf_footprints-F.SilkS.dxf
PCBs/rf/rf_v2/rf_footprints-B.SilkS.dxf
PCBs/rf/rf_v2/rf_footprints-F.SilkS.dxf
PCBs/rf/rf_v2/v4/rf_footprints-B.Cu.dxf
PCBs/rf/rf_v2/v4/rf_footprints-F.Cu.dxf
structure/teneur de_vis.STL
structure/teneur_de_vis_miroir.STL
