pbaron2/station-sol-supsat/PCBs/hall_sensor/hall_sensor-B.Cu.pdf

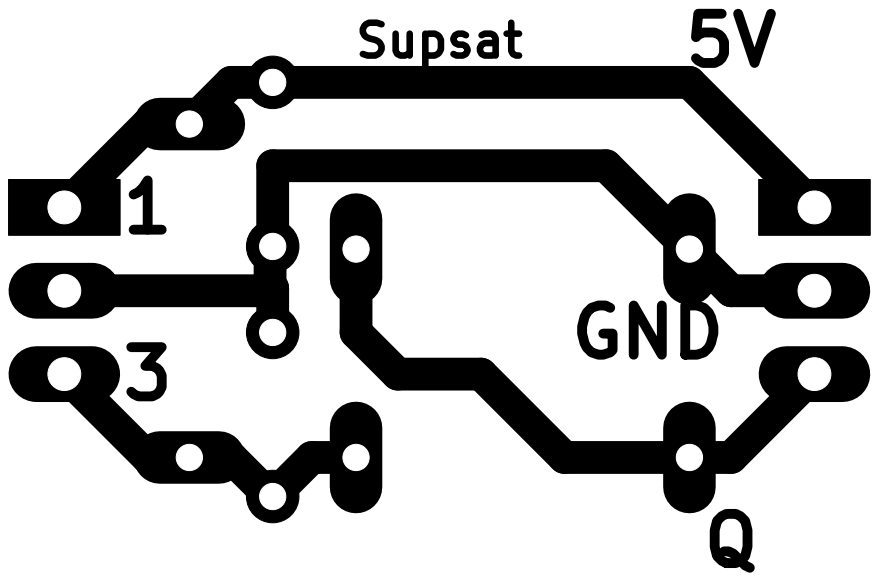
[picture p152: page 1]
