pbaron2/station-sol-supsat/PCBs/hall_sensor/hall_sensor.pdf

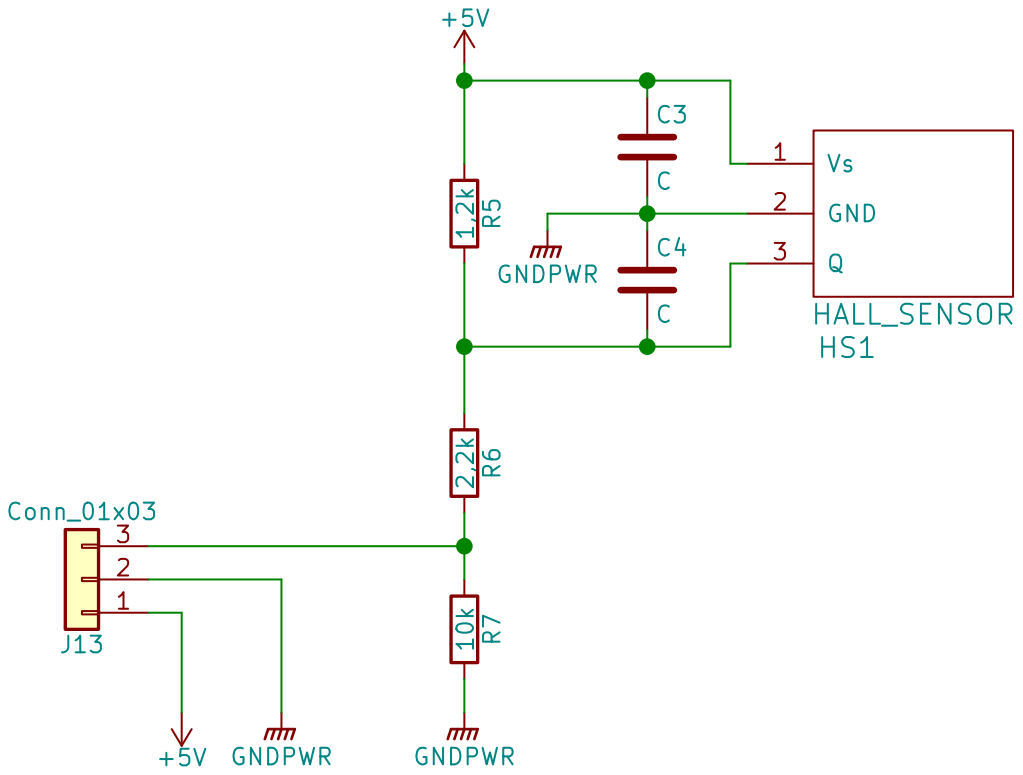
[picture p153: page 1]
