pbaron2/station-sol-supsat/PCBs/principal/tracking_system.pdf

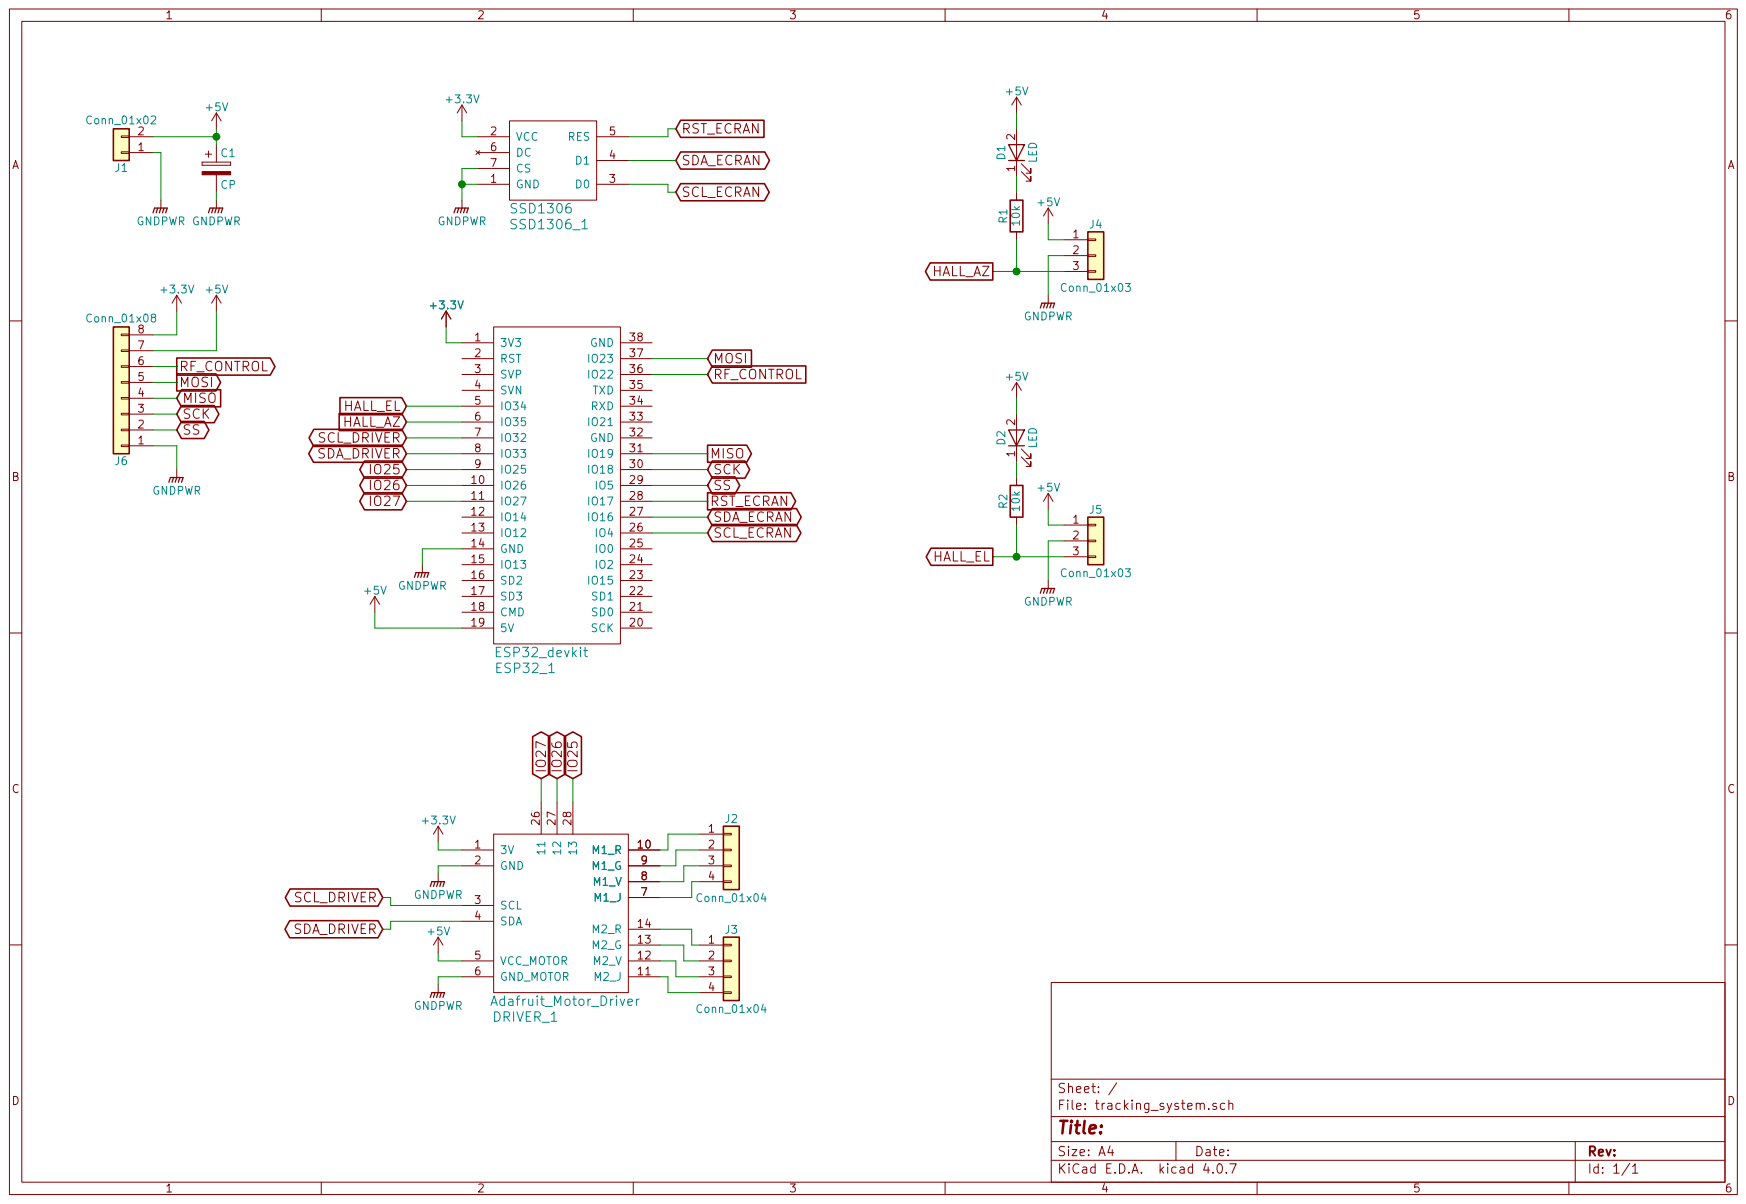
[picture p154: page 1]
