pbaron2/station-sol-supsat/PCBs/rf/rf_footprints.pdf

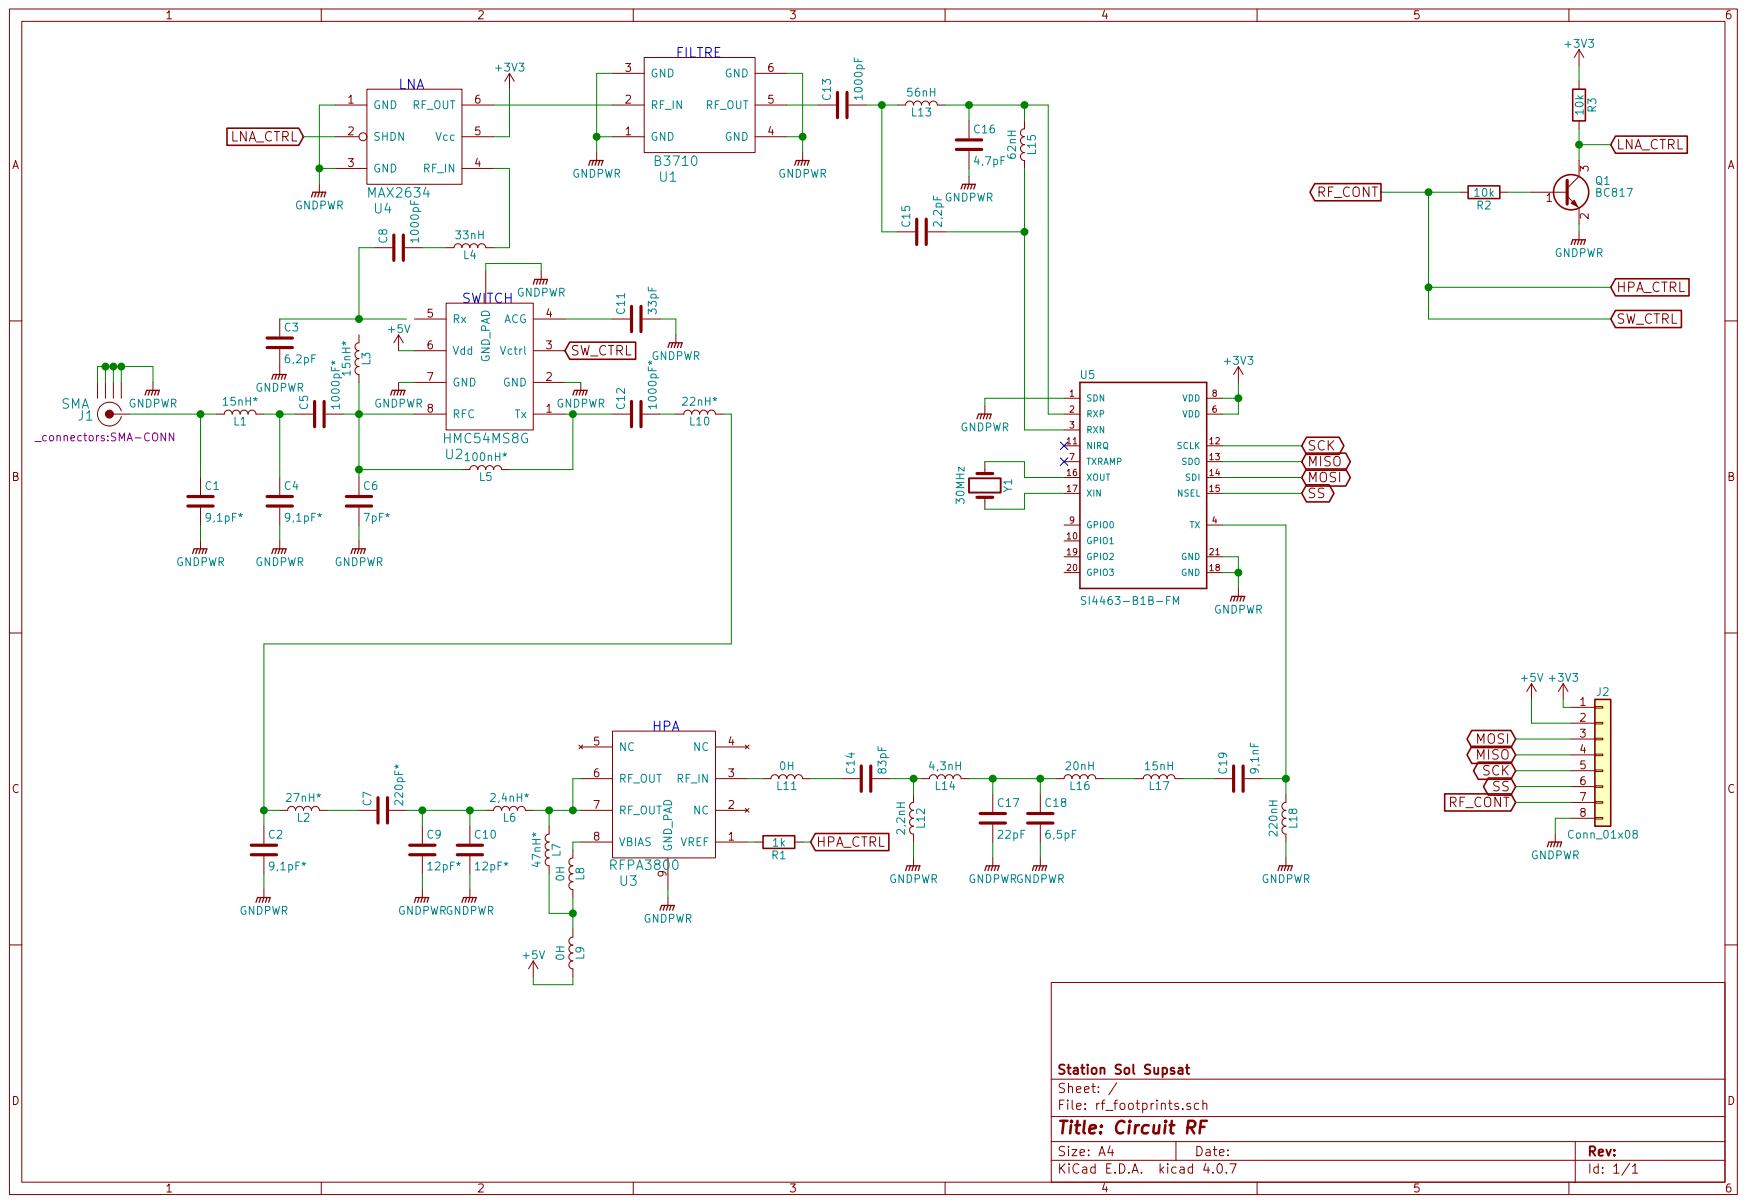
[picture p155: page 1]
