pbaron2/station-sol-supsat/PCBs/principal/v1.1bis/tracking_system-B.Cu.pdf

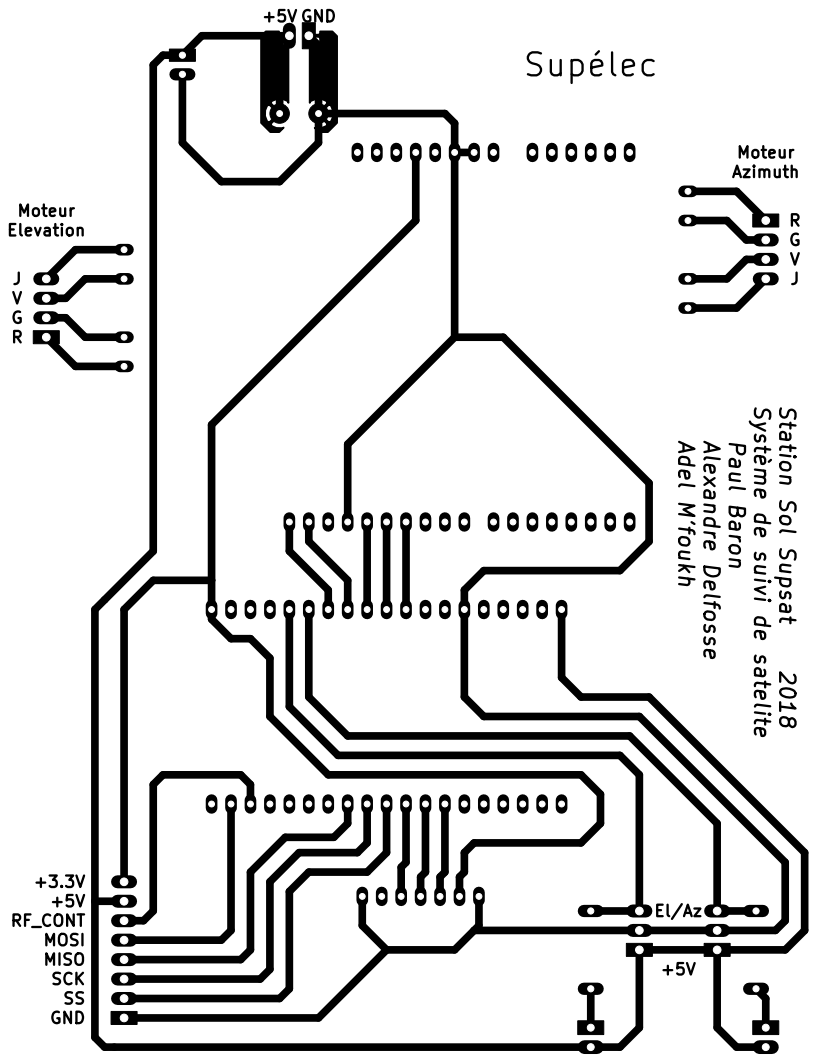
[picture p156: page 1]
