pbaron2/station-sol-supsat/PCBs/rf/rf_v2/rf_footprints.pdf

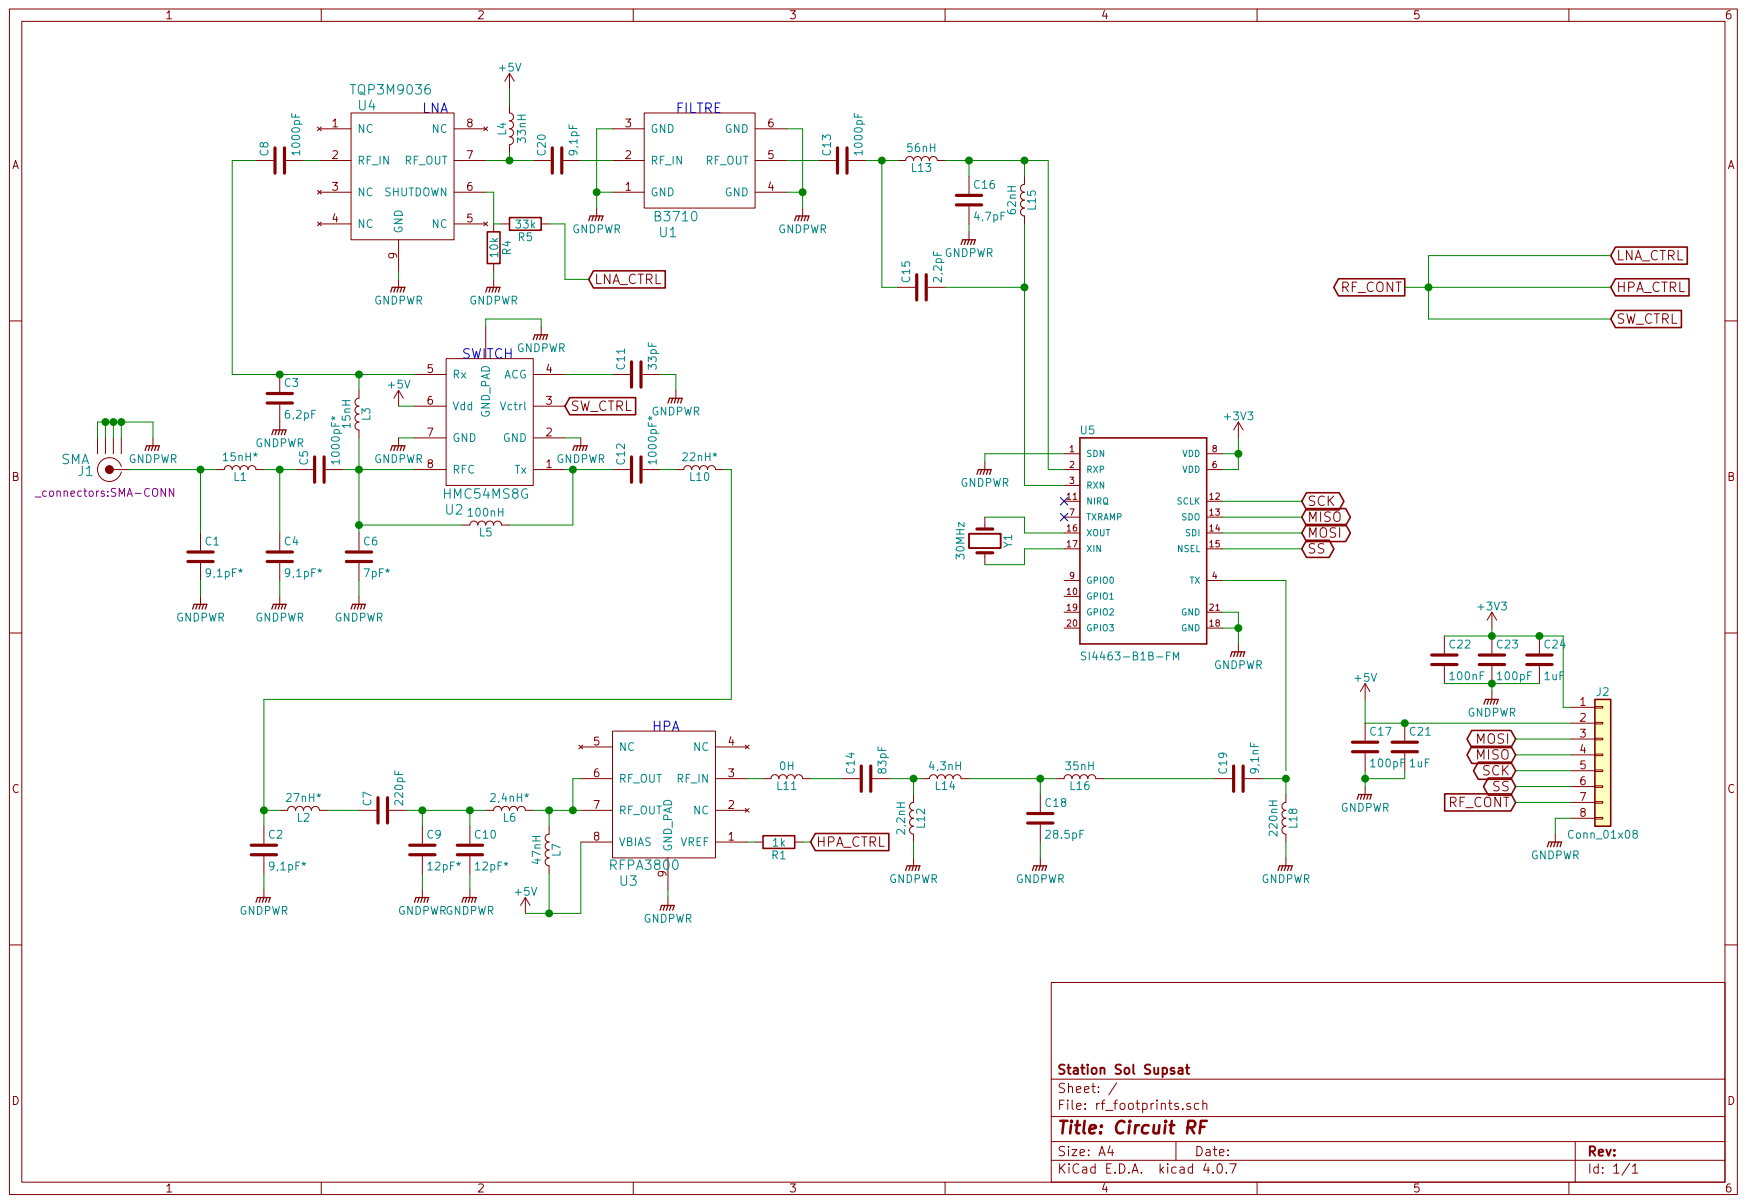
[picture p157: page 1]
