pbaron2/station-sol-supsat/PCBs/rf/rf_v2/v5/rf_footprints-B.Cu.pdf

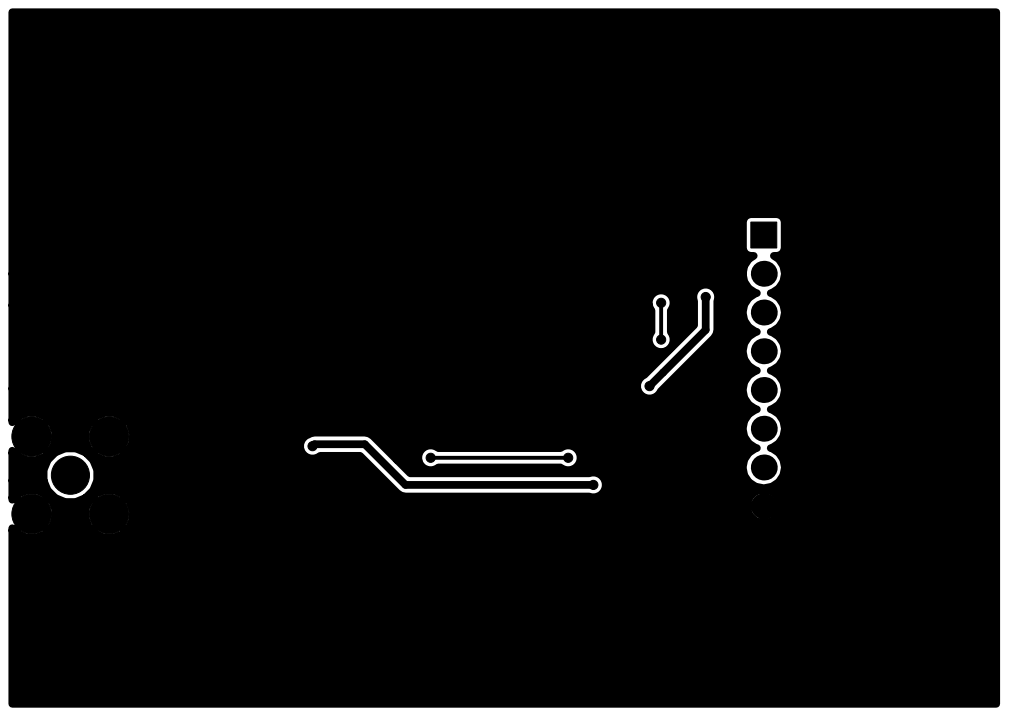
[picture p158: page 1]
