pbaron2/station-sol-supsat/PCBs/rf/rf_v2/v5/rf_footprints-F.Cu.pdf

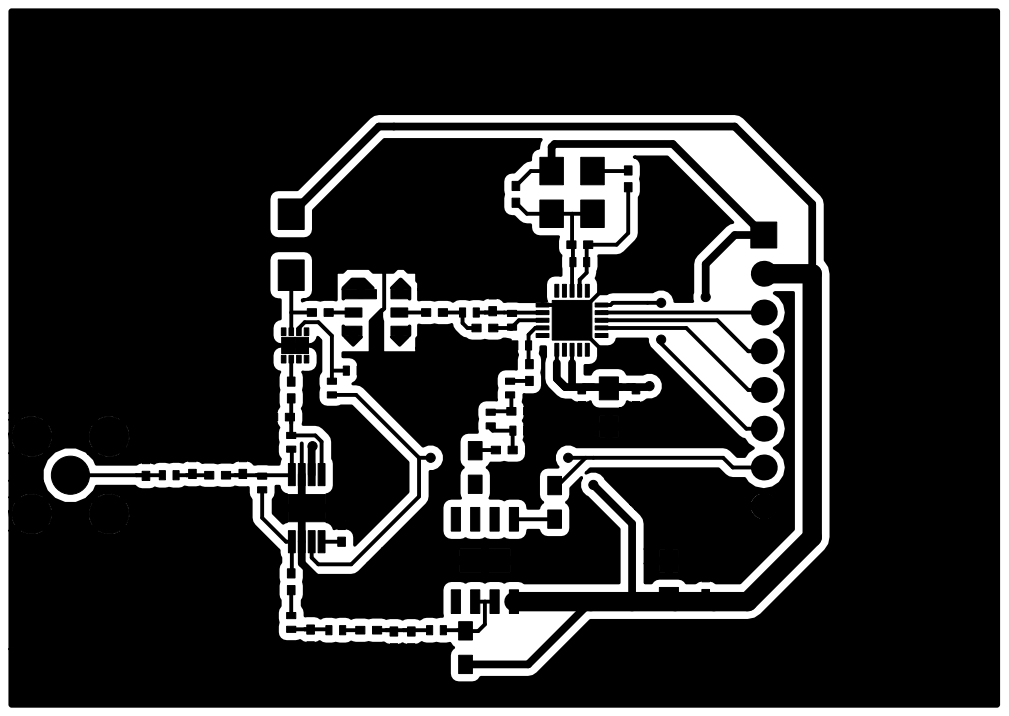
[picture p159: page 1]
