pbaron2/station-sol-supsat/PCBs/rf/rf_v2/v5/rf_footprints.pdf

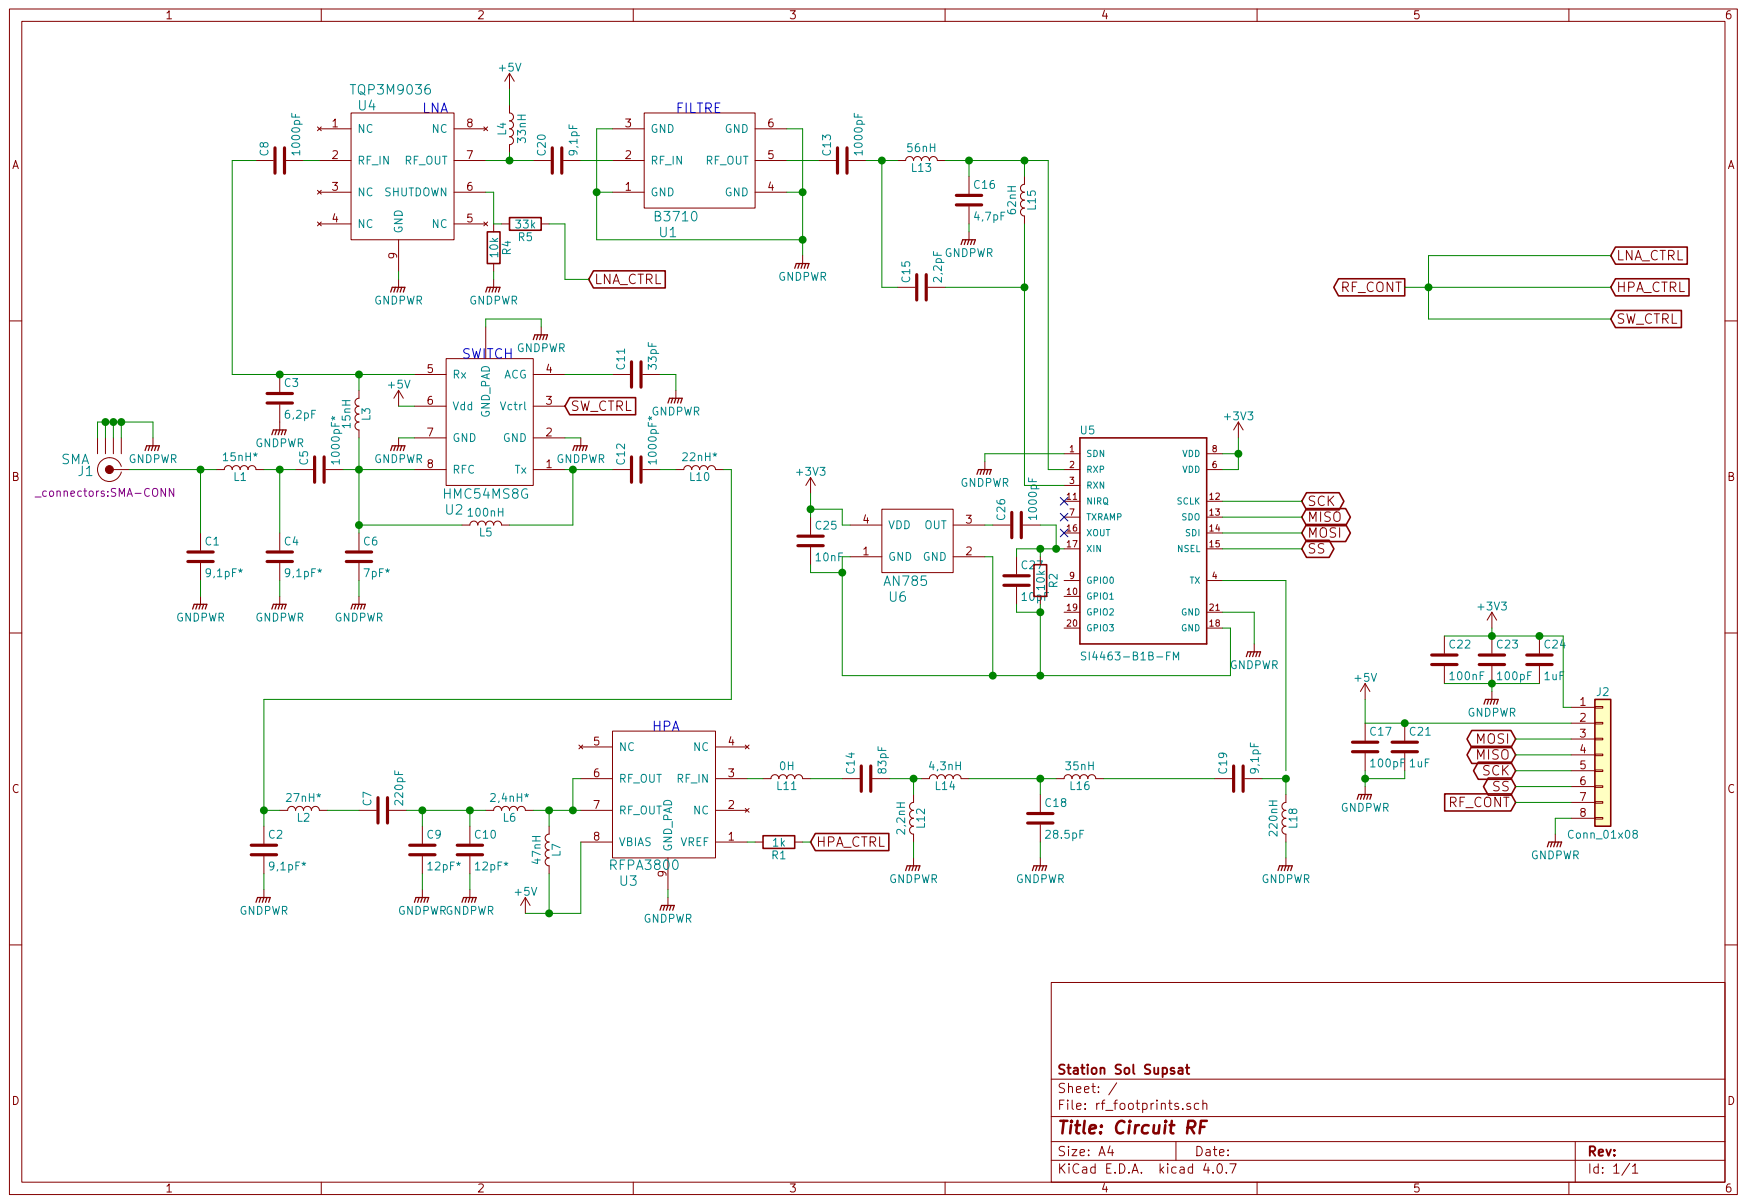
[picture p160: page 1]
