pbaron2/station-sol-supsat/PCBs/rf/rf_v2/v4/rf_footprints-F.Cu.pdf

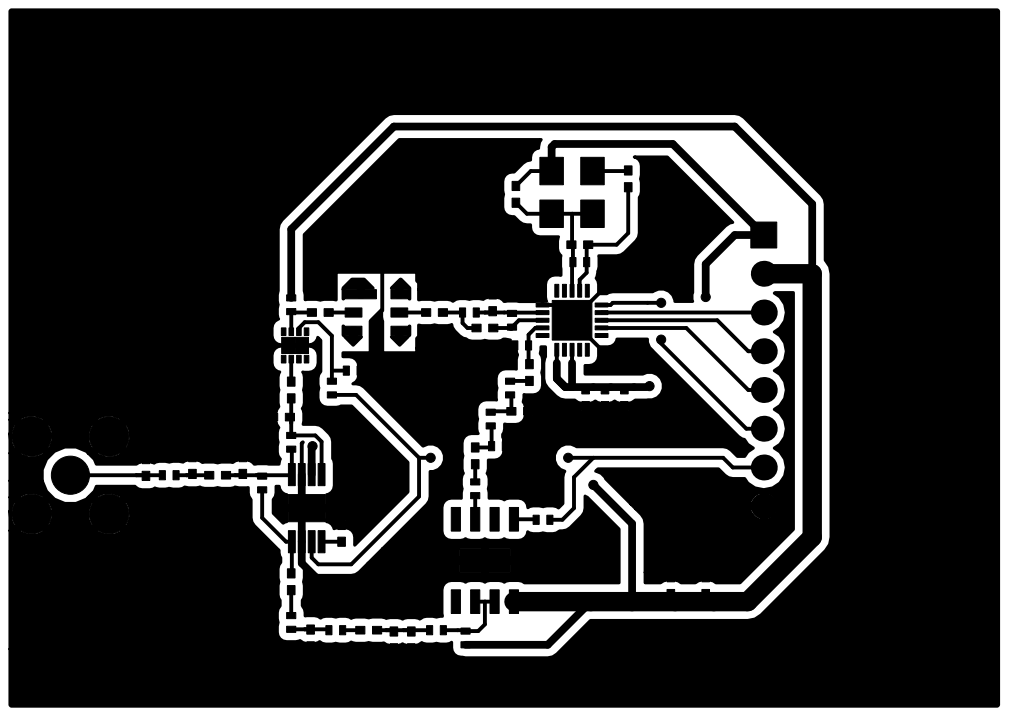
[picture p161: page 1]
