pbaron2/station-sol-supsat/PCBs/rf/rf_v2/v4/rf_footprints-F.SilkS.pdf

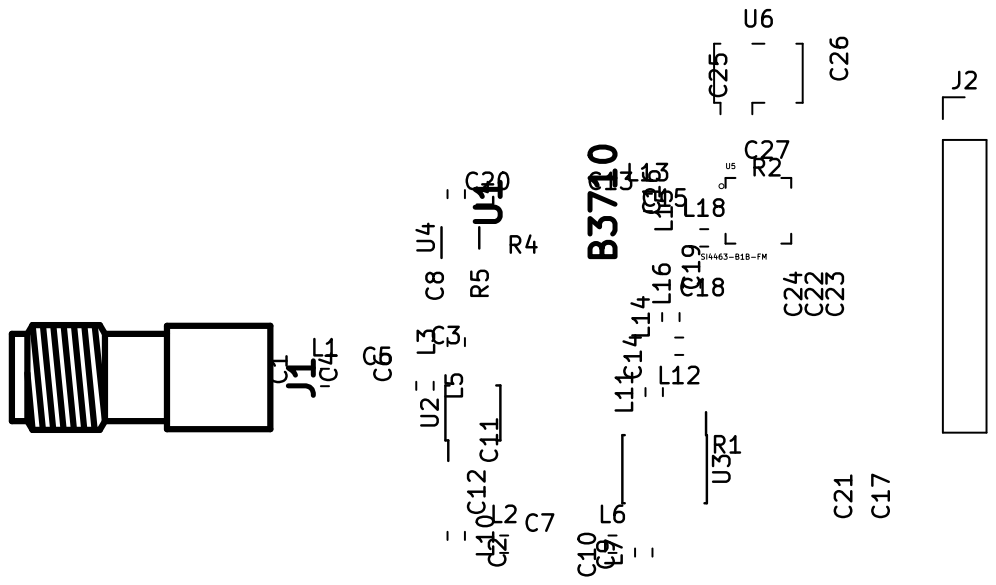
[picture p162: page 1]
