pbaron2/station-sol-supsat/PCBs/rf/rf_v2/v4/rf_footprints.pdf

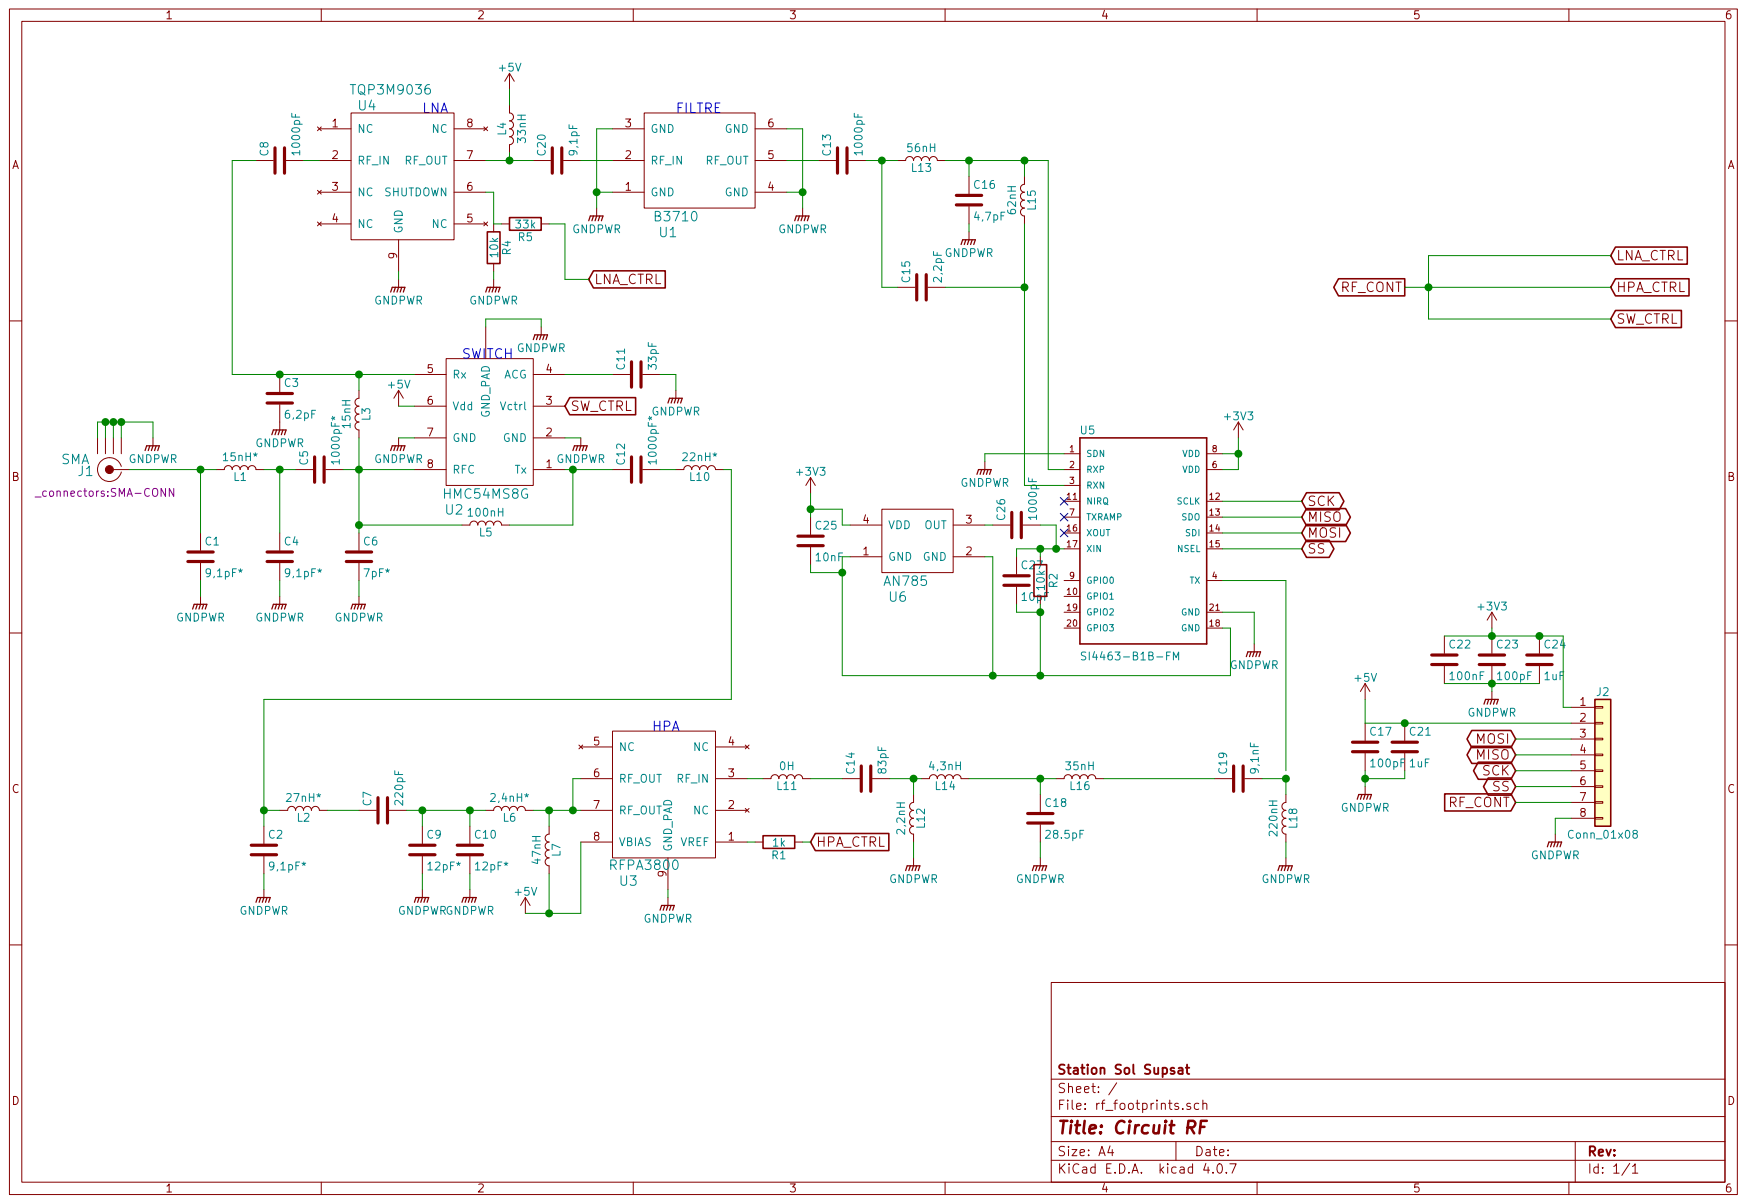
[picture p163: page 1]
