pbaron2/station-sol-supsat/PCBs/hall_sensor/hall_sensor.kicad_pcb

## KiCad design PCBs/hall_sensor/hall_sensor.kicad_pcb (2019-05-30)

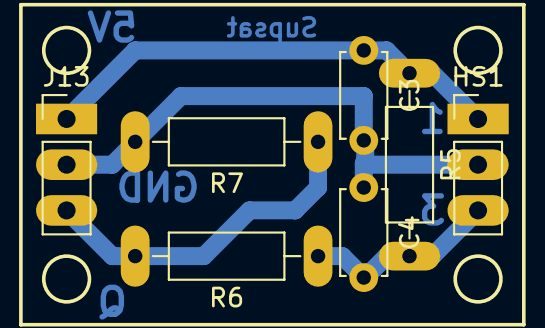
[picture p164: board hall_sensor.kicad_pcb from above]

Board: 2 copper layers, 7 parts (0 on the bottom side), 4 nets.

Parts:
C3, C4: C; C_Disc_D4.7mm_W2.5mm_P5.00mm
HS1: HALL_SENSOR; Pin_Header_Straight_1x03_Pitch2.54mm
J13: Conn_01x03; Pin_Header_Straight_1x03_Pitch2.54mm
R5, R6, R7: R; R_Axial_DIN0207_L6.3mm_D2.5mm_P10.16mm_Horizontal

Connections:
+5V: C3.1, HS1.1, J13.1, R5.1
GNDPWR: C3.2, C4.1, HS1.2, J13.2, R7.2
unnamed: C4.2, HS1.3, R5.2, R6.1
unnamed: J13.3, R6.2, R7.1
