pbaron2/station-sol-supsat/PCBs/principal/tracking_system.kicad_pcb

## KiCad design PCBs/principal/tracking_system.kicad_pcb (2019-05-30)

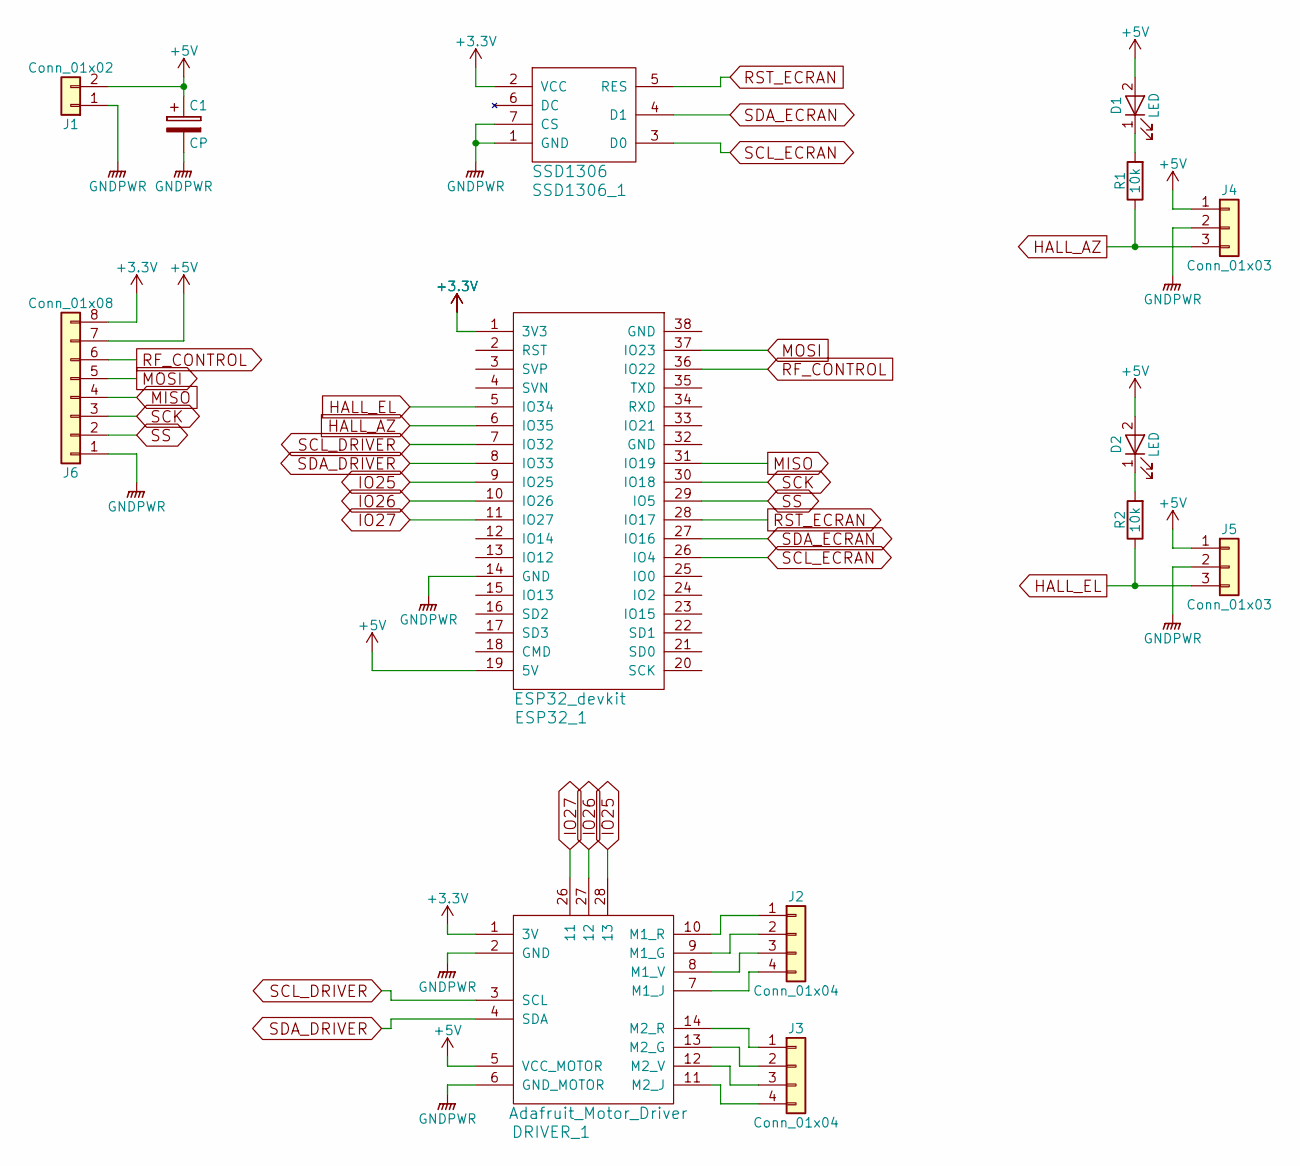
[picture p165: schematic tracking_system.sch]

Parts:
C1: CP; CP_Radial_D8.0mm_P2.50mm
D1, D2: LED; LED_D3.0mm
DRIVER_1: Adafruit_Motor_Driver
ESP32_1: ESP32_devkit
J1: Conn_01x02; Pin_Header_Straight_1x02_Pitch2.54mm
J2, J3: Conn_01x04; Pin_Header_Straight_1x04_Pitch2.54mm
J4, J5: Conn_01x03; Pin_Header_Straight_1x03_Pitch2.54mm
J6: Conn_01x08; Pin_Header_Straight_1x08_Pitch2.54mm
R1, R2: 10k; R_Axial_DIN0207_L6.3mm_D2.5mm_P10.16mm_Horizontal
SSD1306_1: SSD1306

Connections:
+3V3: DRIVER_1.1 (3V), ESP32_1.1 (3V3), J6.8, SSD1306_1.2 (VCC)
+5V: C1.1, D1.2 (A), D2.2 (A), DRIVER_1.5 (VCC_MOTOR), ESP32_1.19 (5V), J1.2, J4.1, J5.1, J6.7
GNDPWR: C1.2, DRIVER_1.2 (GND), DRIVER_1.6 (GND_MOTOR), ESP32_1.14 (GND), J1.1, J4.2, J5.2, J6.1, SSD1306_1.1 (GND), SSD1306_1.7 (CS)
HALL_AZ: ESP32_1.6 (IO35), J4.3, R1.1
HALL_EL: ESP32_1.5 (IO34), J5.3, R2.1
IO25: DRIVER_1.28 (13), ESP32_1.9 (IO25)
IO26: DRIVER_1.27 (12), ESP32_1.10 (IO26)
IO27: DRIVER_1.26 (11), ESP32_1.11 (IO27)
MISO: ESP32_1.31 (IO19), J6.4
MOSI: ESP32_1.37 (IO23), J6.5
unnamed: D1.1 (K), R1.2
unnamed: D2.1 (K), R2.2
unnamed: DRIVER_1.7 (M1_J), J2.4
unnamed: DRIVER_1.8 (M1_V), J2.3
unnamed: DRIVER_1.9 (M1_G), J2.2
unnamed: DRIVER_1.10 (M1_R), J2.1
unnamed: DRIVER_1.11 (M2_J), J3.4
unnamed: DRIVER_1.12 (M2_V), J3.3
unnamed: DRIVER_1.13 (M2_G), J3.2
unnamed: DRIVER_1.14 (M2_R), J3.1
RF_CONTROL: ESP32_1.36 (IO22), J6.6
RST_ECRAN: ESP32_1.28 (IO17), SSD1306_1.5 (RES)
SCK: ESP32_1.30 (IO18), J6.3
SCL_DRIVER: DRIVER_1.3 (SCL), ESP32_1.7 (IO32)
SCL_ECRAN: ESP32_1.26 (IO4), SSD1306_1.3 (D0)
SDA_DRIVER: DRIVER_1.4 (SDA), ESP32_1.8 (IO33)
SDA_ECRAN: ESP32_1.27 (IO16), SSD1306_1.4 (D1)
SS: ESP32_1.29 (IO5), J6.2

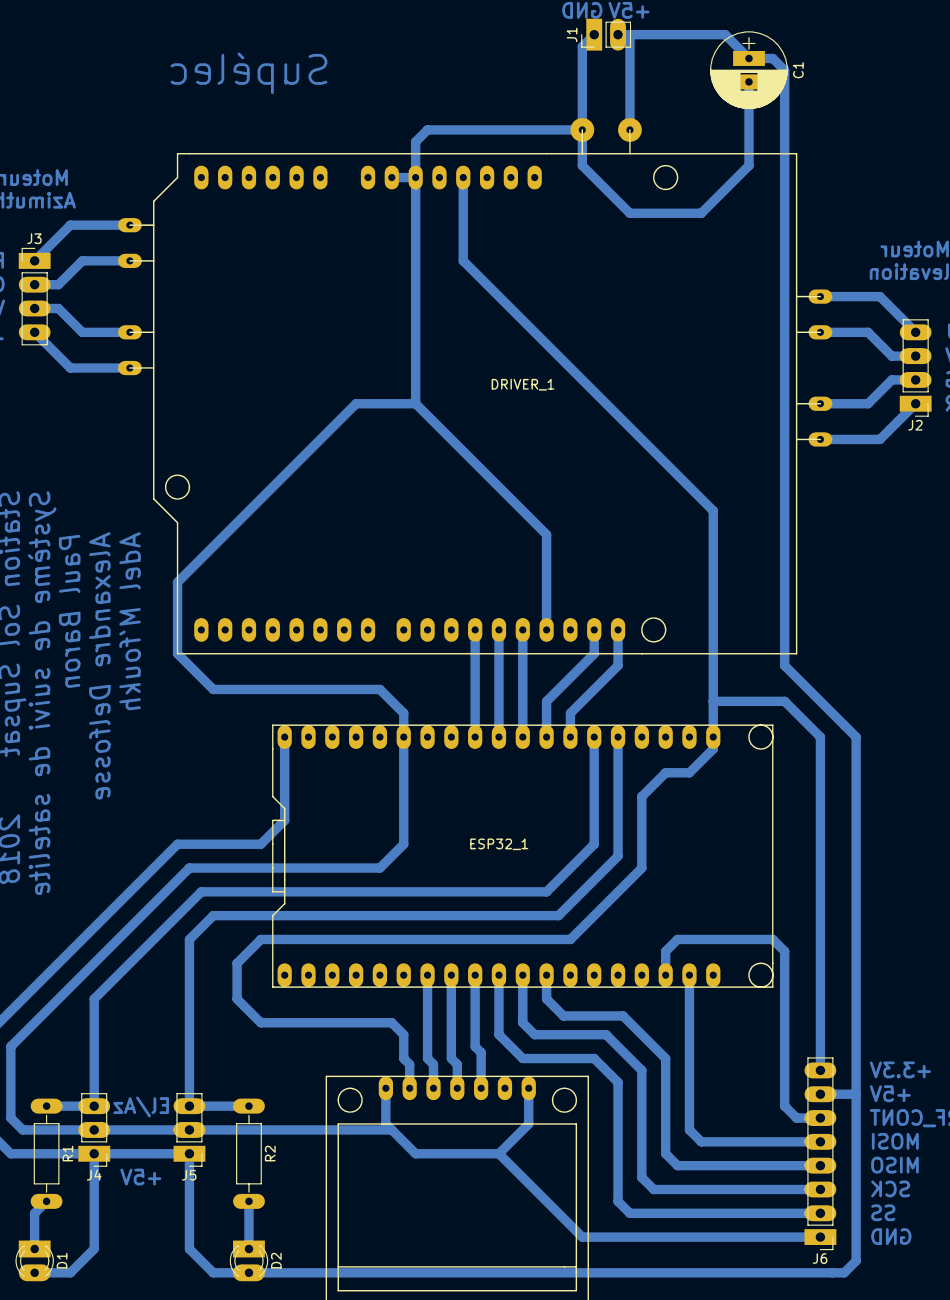
[picture p166: board tracking_system.kicad_pcb from above]

Board: 2 copper layers, 14 parts (0 on the bottom side), 28 nets.
