pbaron2/station-sol-supsat/PCBs/rf/rf_v2/rf_footprints.kicad_pcb

## KiCad design PCBs/rf/rf_v2/rf_footprints.kicad_pcb (2019-05-30)

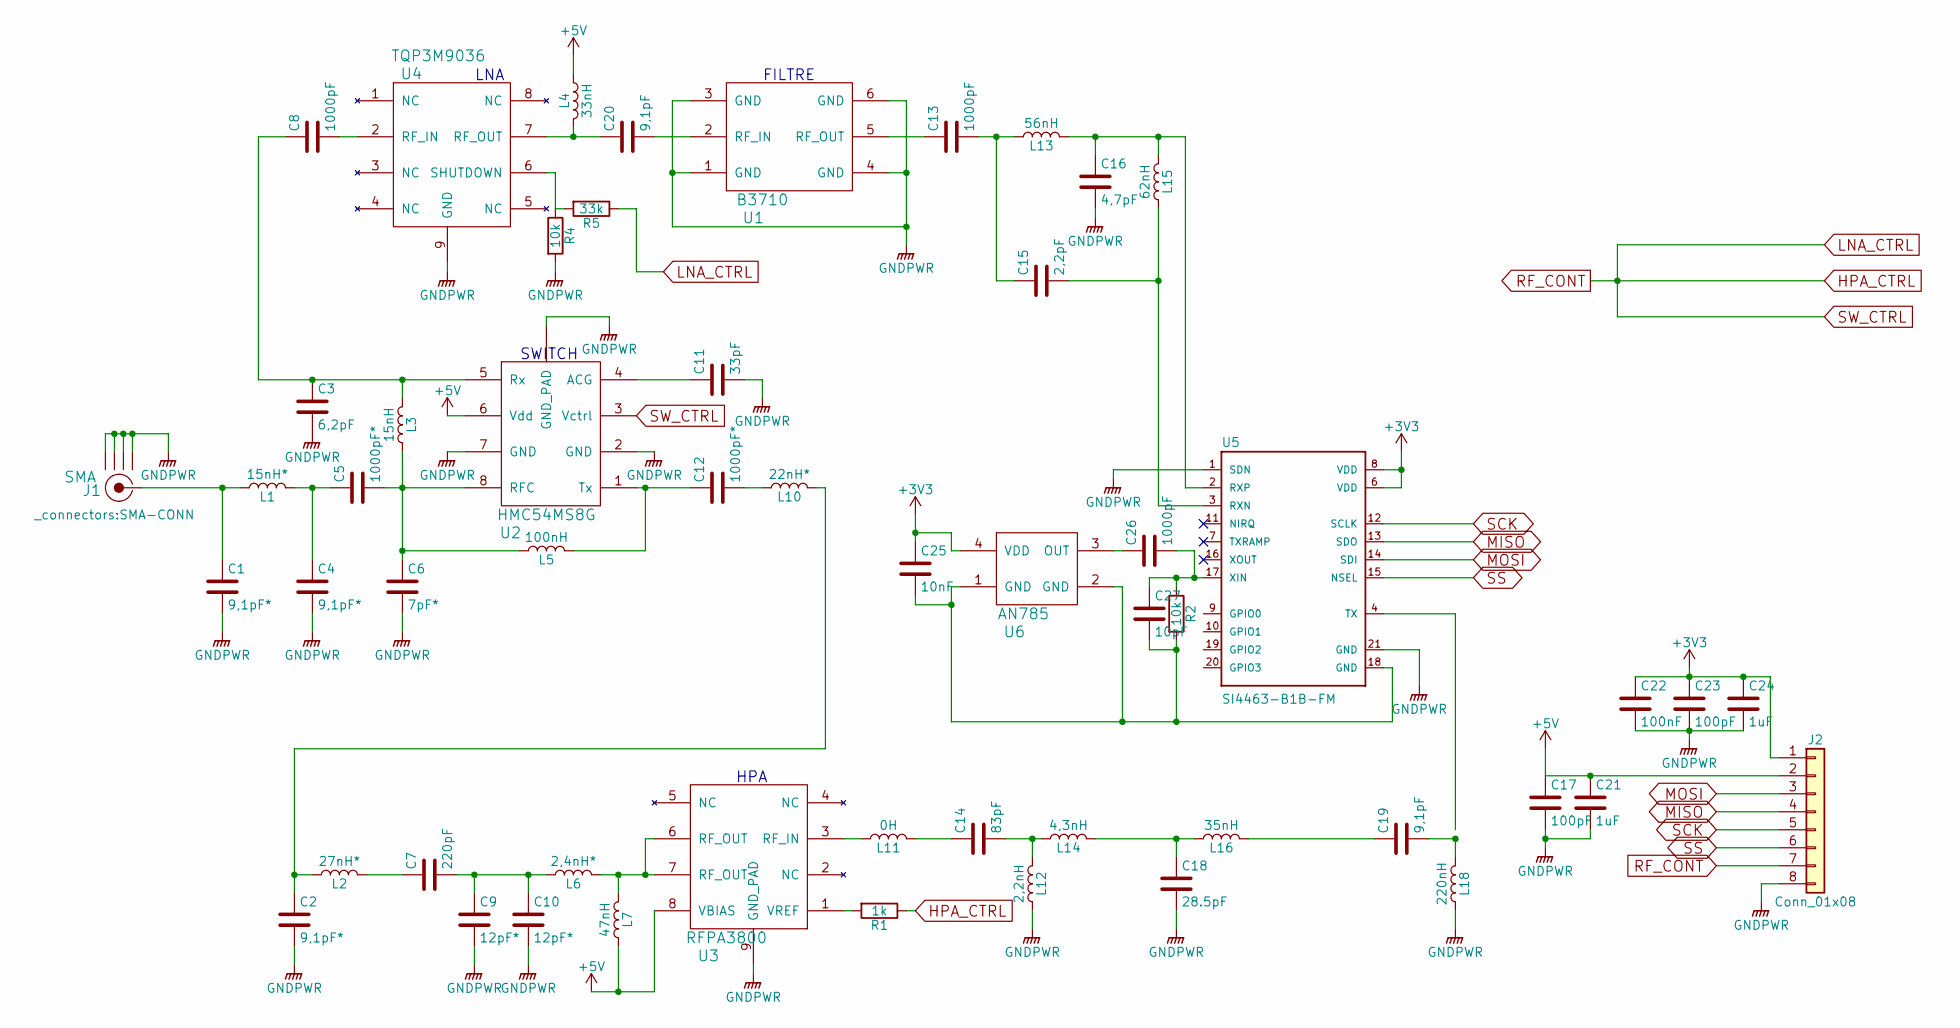
[picture p167: schematic rf_footprints.sch, Circuit RF]

Parts:
C1, C2, C4: 9,1pF*; C_0402_NoSilk
C3: 6,2pF; C_0402_NoSilk
C5, C12: 1000pF*; C_0402_NoSilk
C6: 7pF*; C_0402_NoSilk
C7: 220pF; C_0402_NoSilk
C8, C13, C26: 1000pF; C_0402_NoSilk
C9, C10: 12pF*; C_0402_NoSilk
C11: 33pF; C_0402_NoSilk
C14: 83pF; C_0402_NoSilk
C15: 2,2pF; C_0402_NoSilk
C16: 4,7pF; C_0402_NoSilk
C17, C23: 100pF; C_0402_NoSilk
C18: 28.5pF; C_0402_NoSilk
C19, C20: 9,1pF; C_0402_NoSilk
C21: 1uF; C_0805_HandSoldering
C22: 100nF; C_0805_HandSoldering
C24: 1uF; C_0402_NoSilk
C25: 10nF; C_0402_NoSilk
C27: 10pF; C_0402_NoSilk
J1: SMA; SMA-CONN
J2: Conn_01x08; Pin_Header_Straight_1x08_Pitch2.54mm
L1: 15nH*; L_0402
L2: 27nH*; L_0402
L3: 15nH; L_0402
L4: 33nH; L_1206_HandSoldering
L5: 100nH; L_0402
L6: 2,4nH*; L_0402
L7: 47nH; L_0603_HandSoldering
L10: 22nH*; L_0402
L11: 0H; L_0603_HandSoldering
L12: 2,2nH; L_0402
L13: 56nH; L_0402
L14: 4,3nH; L_0402
L15: 62nH; L_0402
L16: 35nH; L_0402
L18: 220nH; L_0402
R1: 1k; R_0603_HandSoldering
R2, R4: 10k; R_0402_NoSilk
R5: 33k; R_0402_NoSilk
U1: B3710; DCC6C
U2: HMC54MS8G; MSOP-8_3x3mm_Pitch0.65mm
U3: RFPA3800; SOIC-8_3.9x4.9mm_Pitch1.27mm
U4: TQP3M9036; DFN-8-1EP_2x2mm_Pitch0.5mm
U5: SI4463-B1B-FM; QFN50P400X400X90-20N
U6: AN785; Oscillator_SMD_TXC_7C-4pin_5.0x3.2mm_HandSoldering

Connections:
+3V3: C22.1, C23.1, C24.1, C25.1, J2.1, U5.6 (VDD), U5.8 (VDD), U6.4 (VDD)
+5V: C17.1, C21.1, J2.2, L4.1, L7.1, U2.6 (Vdd), U3.8 (VBIAS)
GNDPWR: C1.2, C2.2, C3.2, C4.2, C6.2, C9.2, C10.2, C11.2, C16.2, C17.2, C18.2, C21.2, C22.2, C23.2, C24.2, J1.2 (GND1), J1.3 (GND2), J1.4 (GND3), J1.5 (GND4), J2.8, L12.1, L18.1, R4.2, U1.1 (GND), U1.3 (GND), U1.4 (GND), U1.6 (GND), U2.2 (GND), U2.7 (GND), U2.~ (GND_PAD), U3.9 (GND_PAD), U4.9 (GND), U5.1 (SDN), U5.21 (GND)
HPA_CTRL: J2.7, R1.1, R5.1, U2.3 (Vctrl)
MISO: J2.4, U5.13 (SDO)
MOSI: J2.3, U5.14 (SDI)
unnamed: C1.1, J1.1 (RF), L1.1
unnamed: C2.1, L2.1, L10.2
unnamed: C3.1, C8.1, L3.2, U2.5 (Rx)
unnamed: C4.1, C5.1, L1.2
unnamed: C5.2, C6.1, L3.1, L5.1, U2.8 (RFC)
unnamed: C7.1, L2.2
unnamed: C8.2, U4.2 (RF_IN)
unnamed: C7.2, C9.1, C10.1, L6.1
unnamed: C11.1, U2.4 (ACG)
unnamed: C12.1, L5.2, U2.1 (Tx)
unnamed: C12.2, L10.1
unnamed: C13.1, U1.5 (RF_OUT)
unnamed: C13.2, C15.1, L13.1
unnamed: C14.1, L11.2
unnamed: C14.2, L12.2, L14.1
unnamed: C15.2, L15.1, U5.3 (RXN)
unnamed: C16.1, L13.2, L15.2, U5.2 (RXP)
unnamed: C18.1, L14.2, L16.1
unnamed: C19.1, L16.2
unnamed: C19.2, L18.2
unnamed: C20.1, L4.2, U4.7 (RF_OUT)
unnamed: C20.2, U1.2 (RF_IN)
unnamed: C25.2, C27.2, R2.2, U5.18 (GND), U6.1 (GND), U6.2 (GND)
unnamed: C26.1, U6.3 (OUT)
unnamed: C26.2, C27.1, R2.1, U5.17 (XIN)
unnamed: L6.2, L7.2, U3.6 (RF_OUT), U3.7 (RF_OUT)
unnamed: L11.1, U3.3 (RF_IN)
unnamed: R1.2, U3.1 (VREF)
unnamed: R4.1, R5.2, U4.6 (SHUTDOWN)
SCK: J2.5, U5.12 (SCLK)
SS: J2.6, U5.15 (NSEL)

Notes on the sheet:
SWITCH
LNA
FILTRE
HPA

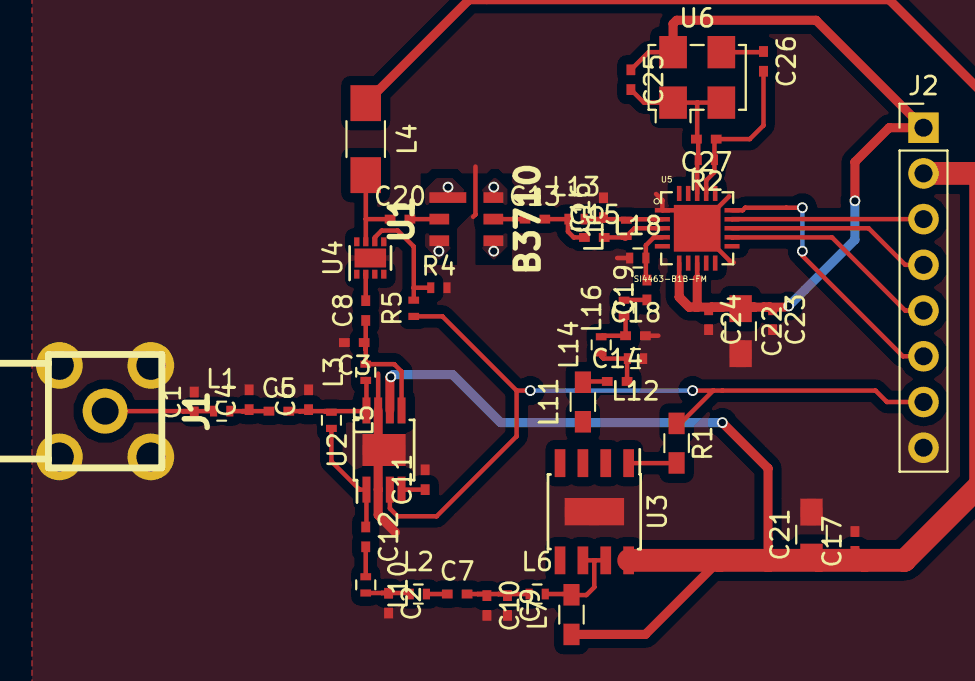
[picture p168: board rf_footprints.kicad_pcb from above]

Board: 2 copper layers, 54 parts (0 on the bottom side), 37 nets.
