pbaron2/station-sol-supsat/codes/captive_portal.h

/*
 *  Station Sol Supsat
 *  	Projet long / Supelec / 2018
 *  		par Paul Baron
 *
 *  captive_portal.cpp
 */
#ifndef CAPTIVE_PORTAL_H_
#define CAPTIVE_PORTAL_H_


bool connectCaptivePortal();

int createSocket();


#endif /* CAPTIVE_PORTAL_H_ */
